a-bissell/microfluidic-causal-chamber/simulation/openfoam/README.md

# OpenFOAM T-Junction Microfluidic Simulation

This directory contains OpenFOAM simulation cases for the microfluidic T-junction causal chamber, providing an open-source alternative to the COMSOL simulation guide.

## Overview

The simulation models two-phase flow (oil-water) droplet generation at a T-junction using:
- **Solver**: `interFoam` (Volume of Fluid method)
- **Physics**: Incompressible Navier-Stokes + VOF interface tracking
- **Surface tension**: Continuum Surface Force (CSF) model

## Directory Structure

```
openfoam/
├── tjunction_2d/           # 2D simulation case (start here)
│   ├── 0/                  # Initial conditions
│   │   ├── U               # Velocity field
│   │   ├── p_rgh           # Pressure
│   │   └── alpha.water     # Phase fraction
│   ├── constant/           # Physical properties
│   │   ├── transportProperties
│   │   ├── turbulenceProperties
│   │   └── g
│   ├── system/             # Solver settings
│   │   ├── blockMeshDict   # Geometry
│   │   ├── controlDict     # Run control
│   │   ├── fvSchemes       # Discretization
│   │   ├── fvSolution      # Linear solvers
│   │   └── setFieldsDict   # Initial interface
│   ├── Allrun              # Run script
│   └── Allclean            # Clean script
│
├── tjunction_2d_serpentine/ # 2D case with inlet resistor channels —
│   │                        # use this for pressure-driven (causal-chamber
│   │                        # actuation) runs; see its README
│   └── gen_blockmesh.py     # parameterized mesh generator
│
├── tjunction_2d_mill/      # digital twin of the millable 400 µm chip
│   │                        # (Makers-Guide PMMA workflow); see its README
│   └── gen_blockmesh.py
│
├── tjunction_3d/           # 3D simulation case
│   └── (same structure with parallel support)
│
├── scripts/                # Python automation
│   ├── extract_droplets.py     # Post-processing
│   ├── run_parametric.py       # Parametric sweeps
│   ├── validate_garstecki.py   # Theory validation
│   └── requirements.txt        # Python dependencies
│
└── README.md               # This file
```

## Quick Start

### Prerequisites

1. **OpenFOAM v2306+** (ESI OpenFOAM or Foundation version)
   - **Linux/Ubuntu**: `sudo apt install openfoam`
   - **Windows**: Use WSL2 (recommended), Docker, or blueCFD-Core
     - See `WINDOWS_SETUP.md` for detailed instructions
   - See: https://www.openfoam.com/download

2. **Python 3.8+** with packages:
   ```bash
   pip install -r scripts/requirements.txt
   ```

3. **ParaView** for visualization:
   ```bash
   sudo apt install paraview    # Linux
   # Windows: Download from https://www.paraview.org/download/
   ```

### Running the 2D Simulation

**Linux / WSL:**
```bash
# Navigate to case directory
cd tjunction_2d

# Make scripts executable
chmod +x Allrun Allclean

# Run the simulation
./Allrun
```

**Windows (with WSL2 installed):**
```powershell
# Navigate to case directory
cd simulation\openfoam\tjunction_2d

# Option 1: Use the batch file
.\Allrun.bat

# Option 2: Run directly through WSL
wsl bash -c "source /opt/openfoam11/etc/bashrc && ./Allrun"
```

This will:
1. Generate the mesh with `blockMesh`
2. Check mesh quality with `checkMesh`
3. Set initial water distribution with `setFields`
4. Run the simulation with `interFoam`
5. Convert results to VTK format

**Expected runtime**: 10-30 minutes (2D), 1-4 hours (3D)

### Viewing Results

```bash
# Open in ParaView
paraview VTK/tjunction_2d.vtk.series

# Or use the OpenFOAM reader
paraFoam
```

In ParaView:
1. Select `alpha.water` to visualize droplets
2. Use "Play" to animate the time series
3. Add velocity vectors with Glyph filter

## Geometry Parameters

From `system/blockMeshDict`:

| Parameter | Value | Description |
|---|---|---|
| w_main | 150 μm | Main channel width |
| w_disp | 75 μm | Dispersed channel width |
| depth | 80 μm | Channel depth |
| L_oil | 500 μm | Oil inlet length |
| L_water | 300 μm | Water inlet length |
| L_outlet | 1000 μm | Outlet length |

## Fluid Properties

From `constant/transportProperties`:

| Phase | Property | Value |
|---|---|---|
| Oil (continuous) | ν | 5×10⁻⁵ m²/s (50 cSt) |
| | ρ | 960 kg/m³ |
| Water (dispersed) | ν | 1×10⁻⁶ m²/s |
| | ρ | 1000 kg/m³ |
| Interface | σ | 0.03 N/m |

## Boundary Conditions

From `0/U` and `0/p_rgh` (velocity-driven, the default since the 2026-07 fix):

| Boundary | Condition | Value |
|---|---|---|
| oil_inlet | fixedValue U | 20 mm/s (Ca = 0.032) |
| water_inlet | fixedValue U | 10 mm/s (Q_disp/Q_cont = 0.25) |
| outlet | fixedValue p | 0 (gauge) |
| walls | noSlip, contact angle | theta0 = 160° (oil-wet) |

> **Why not the original 50/30 kPa pressure inlets?** Over this short
> domain (1.65 mm), 50 kPa drives ~1.2 m/s of oil — a capillary number of
> ~1.9, two orders of magnitude above the droplet-forming regime
> (Ca ≲ 0.02), and the resulting junction pressure (~33 kPa) exceeds the
> 30 kPa water inlet, so water cannot flow in at all. The result is a
> steady stratified film and zero droplets. For pressure-driven runs
> (matching the causal-chamber actuation model), use totalPressure with
> p0 ≈ 850 Pa (oil) and ≈ 650 Pa (water) instead — real chips only see
> tens of kPa because most of it drops across tubing and long serpentine
> channels that this geometry doesn't include.

## Post-Processing

### Extract Droplet Metrics

```bash
python scripts/extract_droplets.py tjunction_2d --output results.csv
```

This extracts:
- Droplet positions and dimensions
- Formation frequency
- Size distribution statistics

### Validate Against Theory

```bash
python scripts/validate_garstecki.py results.csv --plot
```

Compares results to Garstecki scaling law:
```
L/w = 1 + α × (Q_disp/Q_cont)
```

### Parametric Sweep

Preferred: the Docker-based concurrent driver (no local OpenFOAM needed;
runs unchanged on macOS or a many-core Linux/WSL2 box):

```bash
python3 scripts/sweep_pressure.py \
    --base-case tjunction_2d_serpentine \
    --output-dir ~/sweeps/psweep_5x5 \
    --p-cont 10000 11500 13000 14500 16000 \
    --p-disp 2400 2700 3000 3300 3600 \
    --repeats 3 --concurrency 12          # 12 for a 12-core CPU

python3 scripts/analyze_pressure_sweep.py --sweep-dir ~/sweeps/psweep_5x5
```

The analyzer writes per-case metrics, response-map heatmaps, and a
causal-chamber-schema `causal_dataset.csv`. On WSL2, keep `--output-dir`
inside the WSL filesystem (not `/mnt/c/...`) — OpenFOAM's many small
writes are very slow across the Windows bridge; the driver warns if it
detects this.

Legacy sequential driver (requires a local OpenFOAM install):
`scripts/run_parametric.py`.

## Modifying Parameters

### Change Inlet Flow Rates

Edit `0/U`:
```
oil_inlet
{
    type            fixedValue;
    value           uniform (0.02 0 0);   // Keep Ca = mu*U/sigma below ~0.05
}

water_inlet
{
    type            fixedValue;
    value           uniform (0 -0.01 0);  // Sets Q_disp/Q_cont ratio
}
```

For pressure-driven operation, switch both inlets in `0/p_rgh` to
`totalPressure` (see the comments in that file) with p0 of order
100–1000 Pa — **not** tens of kPa; see Boundary Conditions above.

### Change Fluid Properties

Edit `constant/transportProperties`:
```
oil
{
    nu    5e-05;    // Kinematic viscosity (m²/s)
    rho   960;      // Density (kg/m³)
}

sigma   0.03;       // Surface tension (N/m)
```

### Change Simulation Time

Edit `system/controlDict`:
```
endTime         0.1;    // Total simulation time (s)
writeInterval   0.001;  // Output frequency (s)
```

## Troubleshooting

### Simulation Crashes

1. **Reduce time step**: Edit `system/controlDict`:
   ```
   deltaT          1e-8;    // Smaller initial time step
   maxCo           0.3;     // Lower Courant number limit
   ```

2. **Refine mesh near junction**: Add grading in `blockMeshDict`

3. **Check mesh quality**:
   ```bash
   checkMesh -allGeometry -allTopology
   ```

### No Droplets Form

1. **Check the capillary number first**: Ca = mu_cont * U_cont / sigma must
   be ≲ 0.02 (squeezing/dripping regime). Higher Ca means stratified or
   jetting flow — *lowering* velocity/pressure helps, raising it doesn't.
2. **Check the water inlet can actually flow**: with pressure inlets, the
   water p0 must exceed the pressure at the junction (roughly the oil p0
   scaled by the fraction of channel length downstream of the junction),
   or the water phase stalls entirely.
3. **Check contact angle**: walls must be oil-wet, but only moderately —
   theta0 ≥ 120 in alpha.water, comfortably ≥ 130. A measured sweep from
   60° to 170° at 800 µm puts the cliff between **105° and 120°**: 105° and
   below give a continuous thread, 120° through 170° all form plugs and are
   indistinguishable in slug length. 120° is confirmed to drip in 3D too.
   Neutral wetting (90°) does fail, so this is a real requirement.
   (An earlier revision of this list demanded theta0 ≥ 150 and said ≤ 120
   spreads a stable wall film. That was wrong by ~45°: 160° had been chosen
   *because* it dripped, and nothing between 120 and 160 had been run. See
   `results/wetting_2026-08/`.)
4. **Check interfacial tension**: `sigma` in transportProperties is an
   assumption, not a measurement, and it sets the drive — ΔP ∝ Ca·σ·L/w².
   At the designed 800 µm operating point, σ ≤ 5 mN/m gives no droplets at
   all and 8–12 mN/m gives barely-plugs at L/w ≈ 1.08. If a case will not
   drip, check sigma before reaching for the pressures.
5. **Run longer**: at Ca ~ 0.03 the droplet period is ~0.04 s; `endTime`
   must cover several periods.

### Simulation Too Slow

1. **Use 2D first**: Start with tjunction_2d
2. **Coarser mesh**: Reduce cell count in blockMeshDict
3. **Parallel run** (3D):
   ```bash
   # Decompose
   decomposePar
   # Run on 4 cores
   mpirun -np 4 interFoam -parallel
   # Reconstruct
   reconstructPar
   ```

## Output Data Format

The `extract_droplets.py` script outputs CSV compatible with the causal chamber format:

| Column | Description | Units |
|---|---|---|
| time | Simulation time | s |
| droplet_id | Droplet identifier | - |
| centroid_x | X position | μm |
| centroid_y | Y position | μm |
| length | Droplet length | μm |
| width | Droplet width | μm |
| d_equivalent | Equivalent diameter | μm |

## References

### Theory
- Garstecki et al. (2006), "Formation of droplets and bubbles in a microfluidic T-junction", Lab Chip
- Christopher & Anna (2007), "Microfluidic methods for generating continuous droplet streams"

### OpenFOAM
- OpenFOAM User Guide: https://www.openfoam.com/documentation/user-guide
- interFoam documentation: https://www.openfoam.com/documentation/guides/latest/doc/guide-applications-solvers-multiphase-interFoam.html

### Causal Chambers
- Gamella et al. (2025), "Causal chambers as a real-world physical testbed for AI methodology", Nature Machine Intelligence
- Microfluidic chamber plan: `hardware/microfluidic/microfluidic_chamber_plan.md`

## Results

- `droplet_verification.png` — filmstrip of the first verified droplet
  formation after the July 2026 BC fix (2D, corrected boundary conditions).
- [`results/mill3d800_2026-08/`](results/mill3d800_2026-08/) — **the 2D→3D
  correction, measured properly**: 800 µm in 3D against a 2D baseline from
  the same generator, so dimensionality is the only variable. Corner gutters
  make slugs ×0.87 shorter, ×1.12 wider, ×0.63 in volume, at ×1.59 the rate
  and ×1.17 the speed. Validated three ways — mass conservation exact, 3D
  reproduces the textbook square-channel slug bypass ratio (1.31 vs ~1.33)
  which 2D cannot, and the 2D baseline reproduces the pressure-driven run
  exactly. Replaces the withdrawn `mill3d_2026-07` factors.
- [`results/window600_2026-07/`](results/window600_2026-07/) — **operating
  window at 600 µm: 25/25 cells drip at ±30% on both actuators** (12.3–22.9
  cm oil × 5.9–11.0 cm water), so the window's edges are still outside the
  sweep. L/w monotonic in every cell (1.15–2.21); the centre cell reproduces
  the independently-run scale-up case to 7 significant figures. The worry
  that a larger capillary-threshold fraction would narrow the window at
  greater width is not borne out.
- [`results/scaleup_2026-07/`](results/scaleup_2026-07/) — **the chamber
  scales**: 400 → 600 → 800 µm reproduce each other to within 4% on every
  observable (L/w 1.500/1.554/1.550, speed flat at ~28 mm/s, f ∝ 1/w,
  Q ∝ w²), with the 600 and 800 µm points predicted out-of-sample from the
  verified 400 µm one. Drops the fabrication bar from a 1/64" endmill to a
  0.6–0.8 mm tool (stiffness ∝ d⁴). Bo = 0.008 at 800 µm, so there is ~10×
  more width headroom before gravity matters; the binding constraint is
  actuation tolerance, not physics.
- [`results/cyclicity_2026-07/`](results/cyclicity_2026-07/) — **actuation
  mode determines the causal graph**: pressure-driven inlets oscillate at
  exactly the droplet frequency (an emergent, physics-delivered confounded
  pair); velocity-driven inlets are flat to six significant figures
  (severed edges — a syringe pump as physical do-operator). The *strength*
  of the coupling is case-specific, not a chamber constant: a same-geometry
  A/B gives r = +0.31, not the +0.998 first reported, because the coupling
  is impulsive rather than sinusoidal. See the correction in that README.
- [`results/mill3d_2026-07/`](results/mill3d_2026-07/) — the first 3D run:
  the millable chip's junction in full 3D. **Partly superseded** — the run
  was fed 79% more water than the 2D case it was compared against (q = 0.5
  vs the 2D measured 0.28), so the ×1.43 speed and ×2.4 frequency
  "corrections" are confounded and withdrawn. The +3% slug-length
  agreement stands. The BC is fixed; a corrected 3D run has not been made.
- [`results/mesh_convergence_2026-07/`](results/mesh_convergence_2026-07/) —
  9-point 5 µm vs 7.5 µm check on the serpentine case. Solver-level result
  is solid at every point (droplets form, same regime as 7.5 µm). After a
  follow-up run at 2× endTime, 4 of 9 points have clean, repeatable L/w
  measurements agreeing with the published 7.5 µm data to within 3–19%;
  the other 5 (high total flow) surfaced a genuinely open question — either
  a domain-length-limited clustering artifact or a real regime transition
  at the sweep's highest-flow corner — flagged with a concrete next step.
- [`results/mill_2026-07/`](results/mill_2026-07/) — first solve of the
  millable-chip twin (`tjunction_2d_mill`): reference-point verification
  (droplets within 11–23% of the hydraulic design math) plus a 25-case
  operating-window sweep, L/w and speed perfectly monotonic across the
  whole pressure window. Also fixed a geometry-hardcoding bug in the
  analysis scripts along the way (now parameterized, regression-checked).
- [`results/psweep5x5_2026-07/`](results/psweep5x5_2026-07/) — the first full
  dataset: 75 cases (5×5 grid × 3 noisy repeats), droplets in all of them,
  L/w and speed monotonic across every row and column, median repeat
  CV 2.2%. Includes the causal-chamber-schema `causal_dataset.csv`.
- [`results/protocol_v1_2026-07/`](results/protocol_v1_2026-07/) — first
  time-series (SET/WAIT/MSR-style) dataset: 6 chained runs, each a
  shuffled tour of the same 3×3 grid as `psweep_2026-07`. Cross-checked
  against that independent cold-start pilot: median |ΔL/w| = 0.7%. The
  raw material for changepoint detection / temporal causal discovery.
- [`results/psweep_2026-07/`](results/psweep_2026-07/) — pressure-actuated 3×3
  sweep on the serpentine case: droplets in all 9 cells, monotonic
  L/w and speed response maps (the P → Q → droplet causal mechanism).
- [`results/sweep_2026-07/`](results/sweep_2026-07/) — first parametric
  sweep: 9 velocity-driven cases (all forming droplets, 10–43 Hz) recovering
  the Garstecki scaling law with α = 1.24, R² = 0.94, plus pressure-driven
  pilots mapping the capillary entry-pressure threshold.

## Viewer

A dependency-free static viewer for the results lives in [`viewer/`](viewer/):
a 2D `alpha.water` playback of a drip cycle, the 3D droplet isosurface, and
swept droplet metrics. No backend, no build step — serve the folder and open it:

```bash
python3 -m http.server 8000   # from this directory
# open http://localhost:8000/viewer/
```

Regenerate its data from a run with [`viewer/export_web.py`](viewer/export_web.py);
see [`viewer/README.md`](viewer/README.md).

## Comparison: OpenFOAM vs COMSOL

| Aspect | OpenFOAM | COMSOL |
|---|---|---|
| Cost | Free (open-source) | ~$5,000+ license |
| Interface method | VOF | Phase Field |
| Ease of use | Command-line, steeper learning | GUI, more intuitive |
| Customization | Full source access | Limited |
| Parallelization | Excellent (MPI) | Good |
| Community | Large, active | Commercial support |

Both approaches are valid for this application. OpenFOAM provides a free, fully open-source solution that can be shared without license restrictions.

## License

This simulation setup is provided under the MIT License as part of the Microfluidic Causal Chamber project.

## Contact

For questions about this simulation:
- Open an issue on GitHub
- See the main project README for contact information
