a-bissell/microfluidic-causal-chamber/hardware/microfluidic/mcc_plumbing.png

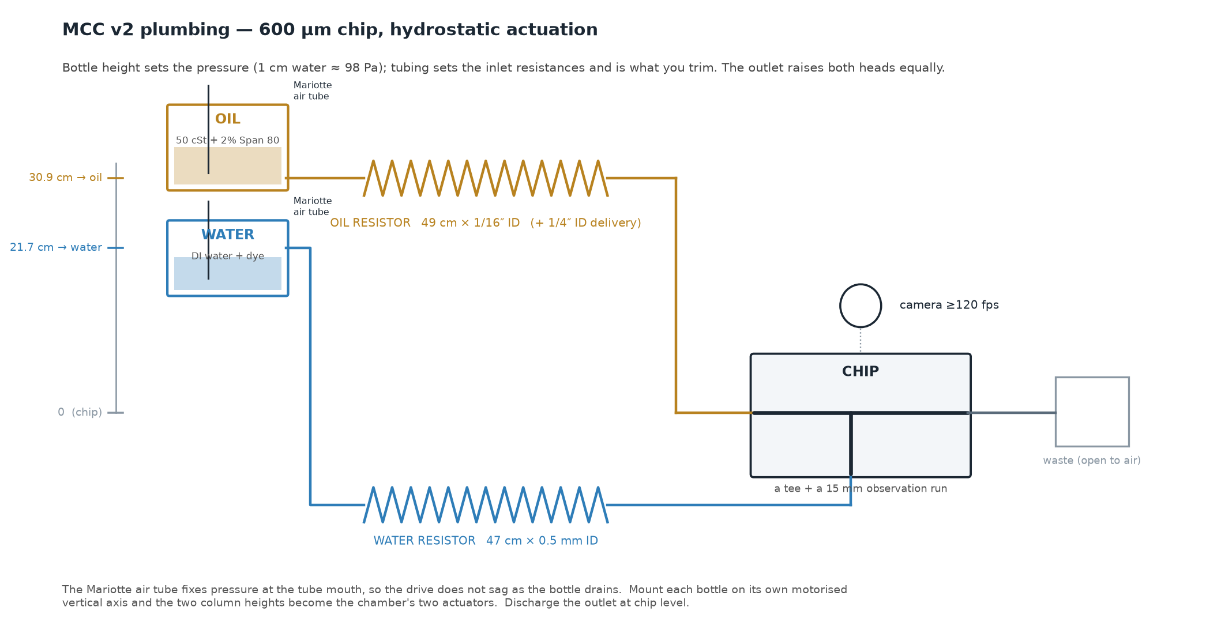
hardware/microfluidic/mcc_plumbing.png
