a-bissell/microfluidic-causal-chamber/hardware/microfluidic/mill_chip_v1_preview.png

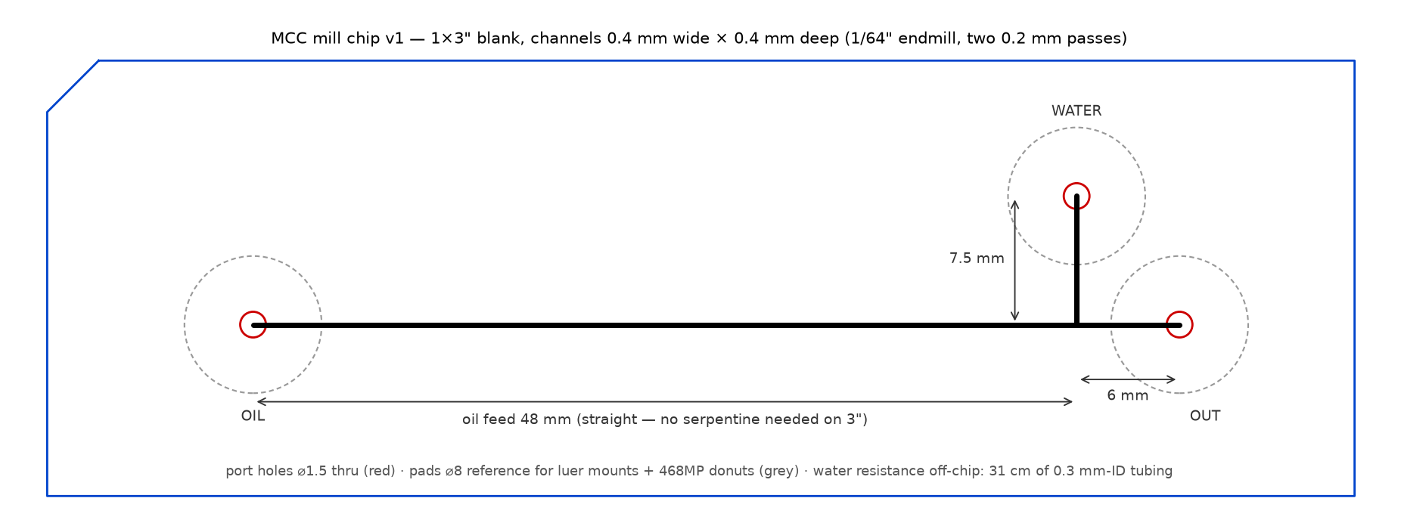
hardware/microfluidic/mill_chip_v1_preview.png
