a-bissell/microfluidic-causal-chamber/hardware/microfluidic/mill_chip_v2_layout.png

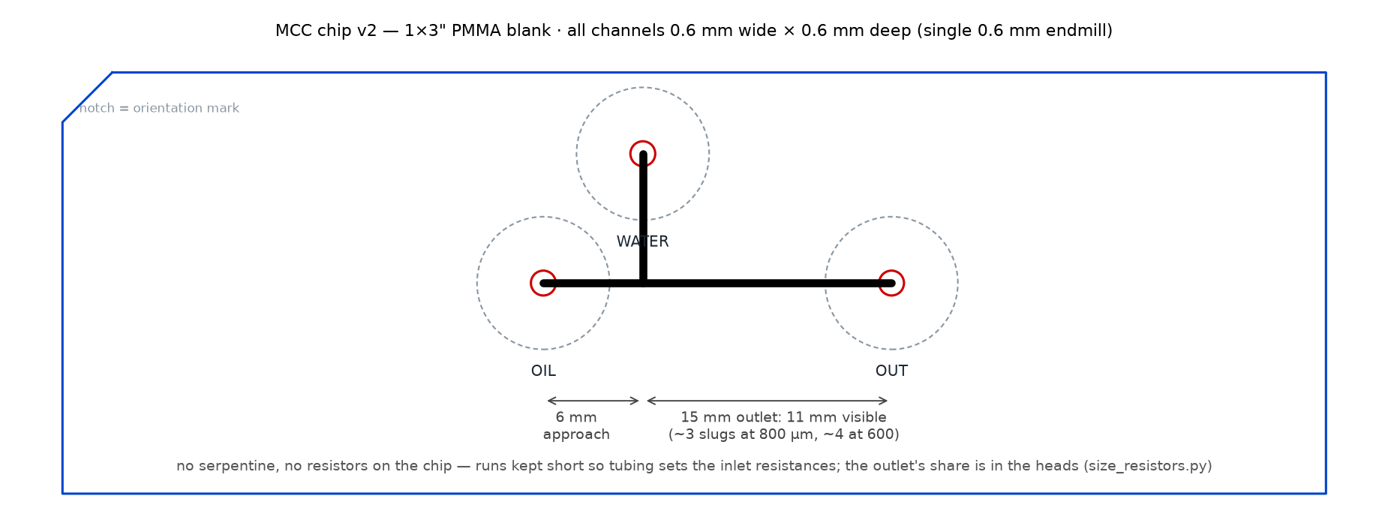
hardware/microfluidic/mill_chip_v2_layout.png
