a-bissell/microfluidic-causal-chamber/hardware/microfluidic/print_test/print_test_plate.step

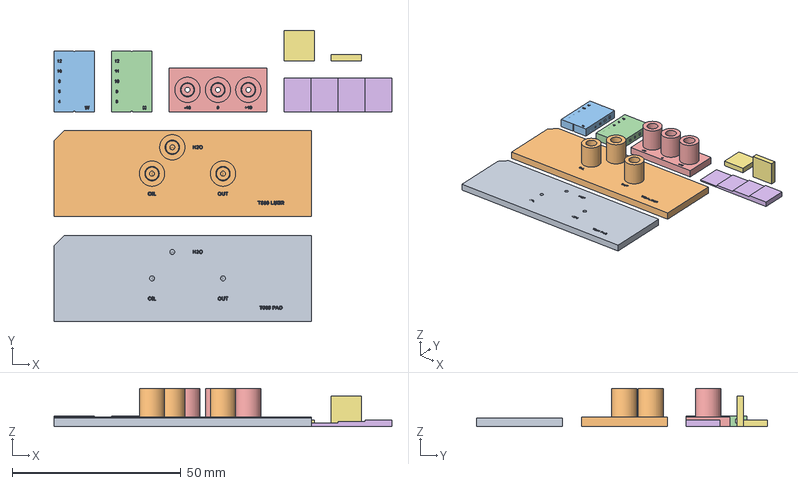
[picture p7: CAD file, 2026-10-15]
hardware/microfluidic/print_test/print_test_plate.step
100.0 x 86.0 x 11.3 mm
T600_pad
T800_luer
W_width
H_height
LUER_gauge
OPT_wedge
THF_flat
THV_upright
