a-bissell/microfluidic-causal-chamber/hardware/microfluidic/print_test/stl/T600_pad.stl

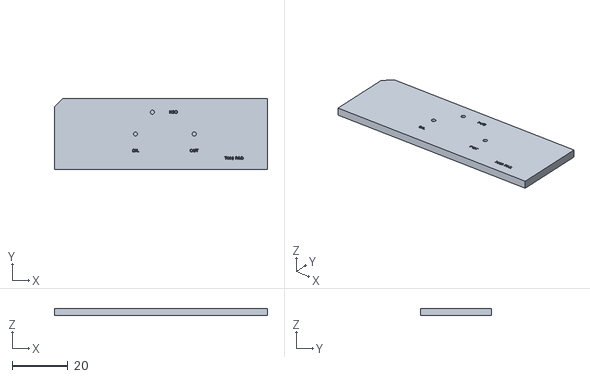
[picture p8: CAD file, 2026-10-15]
hardware/microfluidic/print_test/stl/T600_pad.stl
76.2 x 25.4 x 2.60
