a-bissell/microfluidic-causal-chamber/hardware/microfluidic/print_test/stl/T800_luer.stl

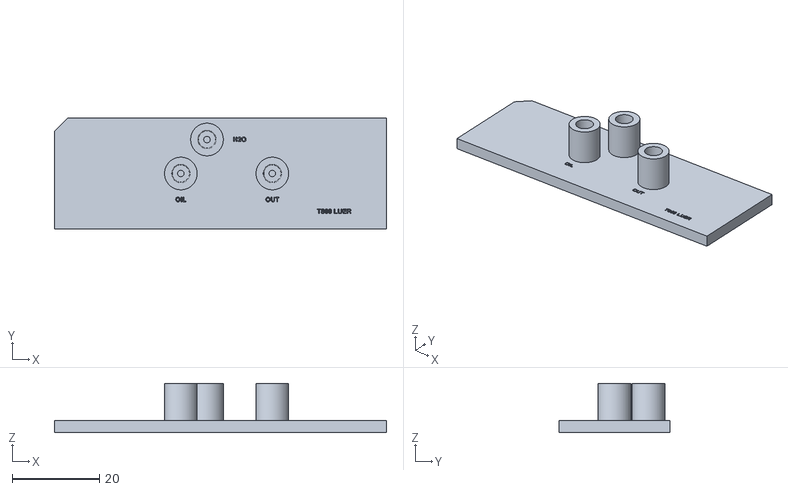
[picture p9: CAD file, 2026-10-15]
hardware/microfluidic/print_test/stl/T800_luer.stl
76.2 x 25.4 x 11.3
