a-bissell/microfluidic-causal-chamber/hardware/microfluidic/print_test/stl/W_width.stl

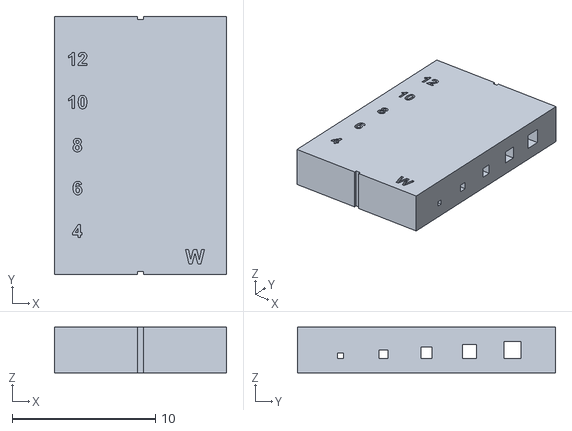
[picture p11: CAD file, 2026-10-15]
hardware/microfluidic/print_test/stl/W_width.stl
12.0 x 18.0 x 3.20
