a-bissell/microfluidic-causal-chamber/hardware/microfluidic/print_test/stl/OPT_wedge.stl

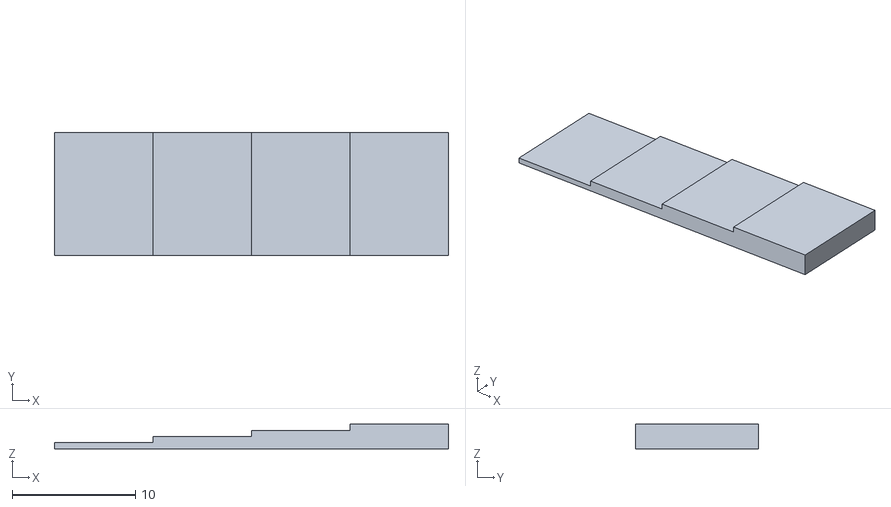
[picture p12: CAD file, 2026-10-15]
hardware/microfluidic/print_test/stl/OPT_wedge.stl
32.0 x 10.0 x 2.00
