a-bissell/microfluidic-causal-chamber/hardware/microfluidic/print_test/stl/LUER_gauge.stl

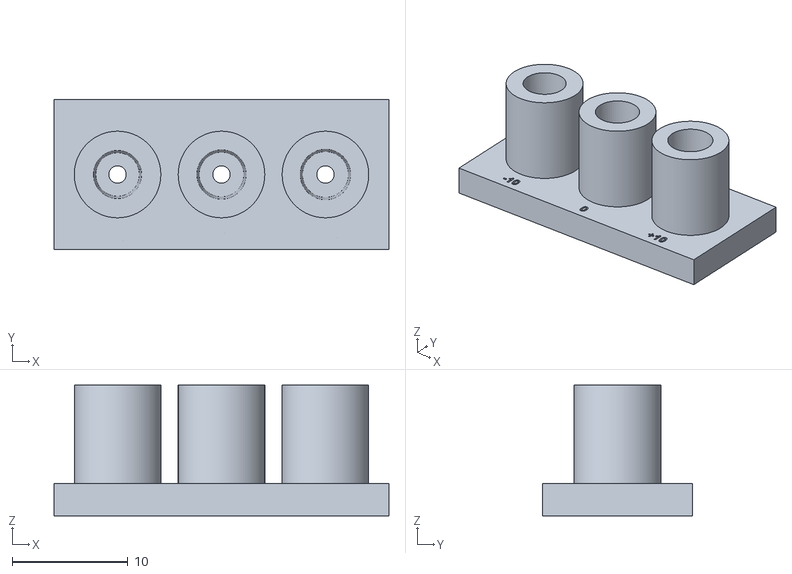
[picture p13: CAD file, 2026-10-15]
hardware/microfluidic/print_test/stl/LUER_gauge.stl
29.0 x 13.0 x 11.3
