a-bissell/microfluidic-causal-chamber/hardware/microfluidic/print_test/stl/THV_upright.stl

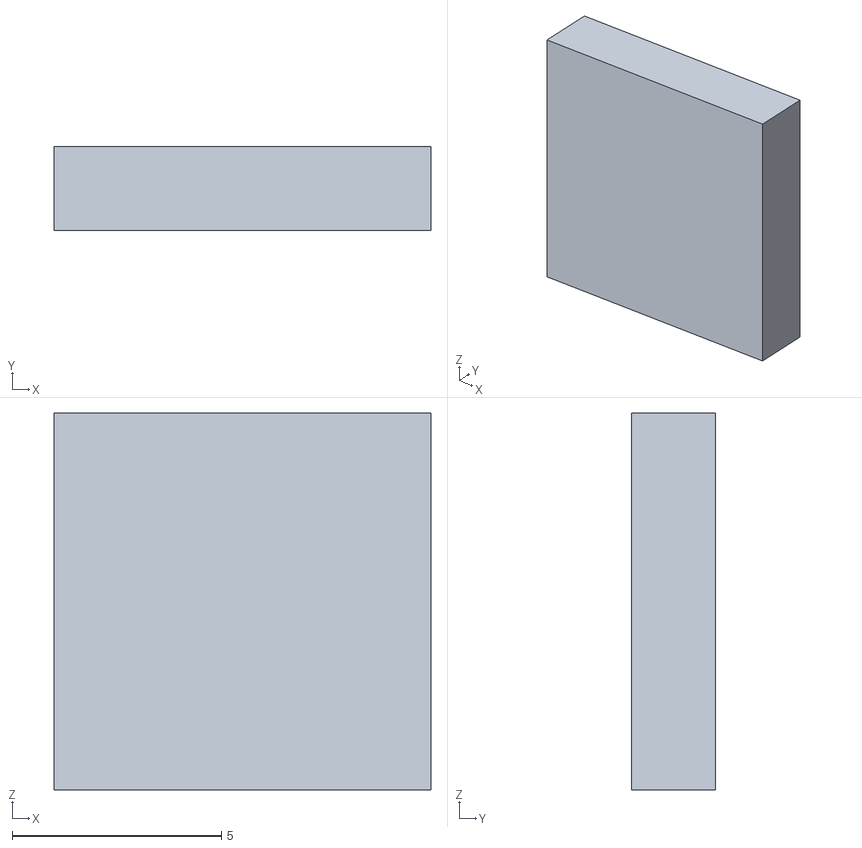
[picture p14: CAD file, 2026-10-15]
hardware/microfluidic/print_test/stl/THV_upright.stl
9.00 x 2.00 x 9.00
