a-bissell/microfluidic-causal-chamber/(list of files, cad)

Other CAD files:
hardware/microfluidic/print_test/stl/THF_flat.stl
