a-bissell/microfluidic-causal-chamber/simulation/openfoam/results/cyclicity_2026-07/ab_flux_pressure_arm.csv

time | Q_oil_inlet_uL_s | Q_water_inlet_uL_s
0.0 | 0.0 | 0.0
0.001 | 0.2374819399484238 | 0.07762473382192556
0.002 | 0.23719471113407808 | 0.07599027639530428
0.003 | 0.23669033627218908 | 0.07707785161430558
0.004 | 0.236071086871936 | 0.07874240118573021
0.005 | 0.23535867317935696 | 0.08090156901351099
0.006 | 0.23448911110044013 | 0.08269645045134077
0.007 | 0.23367810834795164 | 0.0839527991732622
0.008 | 0.23311274005486843 | 0.08571650105423732
0.009 | 0.2325918472562896 | 0.08701743031750193
0.01 | 0.23207739622947077 | 0.0880647724081915
0.011 | 0.2317517090092946 | 0.08917297604614775
0.012 | 0.2311884205457139 | 0.08993205671317894
0.013 | 0.23092966002642748 | 0.0906956300795383
0.014 | 0.23096597937061086 | 0.09146830619117818
0.015 | 0.23082771597054316 | 0.09222853238477938
0.016 | 0.23076340777592783 | 0.09269010024381433
0.017 | 0.23079233763440404 | 0.09306397329417244
0.018 | 0.23101294373146783 | 0.09301310520894364
0.019 | 0.23103258755903971 | 0.09175422850545997
0.02 | 0.2311787914155236 | 0.08915552604432943
0.021 | 0.23431562582490714 | 0.0705543449014995
0.022 | 0.23672970662907328 | 0.07364618258117313
0.023 | 0.23633079510501992 | 0.07346600745672423
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
