a-bissell/microfluidic-causal-chamber/simulation/openfoam/results/cyclicity_2026-07/ab_flux_velocity_arm.csv

time | Q_oil_inlet_uL_s | Q_water_inlet_uL_s
0.0 | 0.23801999249400288 | 0.08200799010036565
0.001 | 0.23801999249400288 | 0.08200799010036565
0.002 | 0.23801999249400288 | 0.08200799010036565
0.003 | 0.23801999249400288 | 0.08200799010036565
0.004 | 0.23801999249400288 | 0.08200799010036565
0.005 | 0.23801999249400288 | 0.08200799010036565
0.006 | 0.23801999249400288 | 0.08200799010036565
0.007 | 0.23801999249400288 | 0.08200799010036565
0.008 | 0.23801999249400288 | 0.08200799010036565
0.009 | 0.23801999249400288 | 0.08200799010036565
0.01 | 0.23801999249400288 | 0.08200799010036565
0.011 | 0.23801999249400288 | 0.08200799010036565
0.012 | 0.23801999249400288 | 0.08200799010036565
0.013 | 0.23801999249400288 | 0.08200799010036565
0.014 | 0.23801999249400288 | 0.08200799010036565
0.015 | 0.23801999249400288 | 0.08200799010036565
0.016 | 0.23801999249400288 | 0.08200799010036565
0.017 | 0.23801999249400288 | 0.08200799010036565
0.018 | 0.23801999249400288 | 0.08200799010036565
0.019 | 0.23801999249400288 | 0.08200799010036565
0.02 | 0.23801999249400288 | 0.08200799010036565
0.021 | 0.23801999249400288 | 0.08200799010036565
0.022 | 0.23801999249400288 | 0.08200799010036565
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
