a-bissell/microfluidic-causal-chamber/simulation/openfoam/results/cyclicity_2026-07/flux_pressure_driven_pc13k_pd3k.csv

time | Q_oil_inlet_uL_s | Q_water_inlet_uL_s
0.0 | 0.0 | 0.0
0.001 | 0.2351840954430259 | 0.07282208592169415
0.002 | 0.23484669256771162 | 0.0719275680621035
0.003 | 0.23435621789547817 | 0.07244669526152145
0.004 | 0.2337793962145963 | 0.07368670311867126
0.005 | 0.23306717514046638 | 0.07587872941568573
0.006 | 0.23235116023092617 | 0.07742400308995989
0.007 | 0.2317216703989011 | 0.07864566613436122
0.008 | 0.23098499875587727 | 0.08021943826957023
0.009 | 0.2302178855324196 | 0.08132161863528564
0.01 | 0.22968048300851465 | 0.08237421242274974
0.011 | 0.22927344738350905 | 0.0832186325966002
0.012 | 0.2288914404924696 | 0.0840653088067063
0.013 | 0.22868965680252595 | 0.08469419270599729
0.014 | 0.2284417454531683 | 0.08536459718513646
0.015 | 0.22836761553333132 | 0.08596666794597396
0.016 | 0.22843969766119848 | 0.08671853853106393
0.017 | 0.22832843628501642 | 0.08713941124258254
0.018 | 0.22844769772166743 | 0.08757075424603933
0.019 | 0.22838766988743764 | 0.08751129640234019
0.02 | 0.2284817979094341 | 0.0869124323725957
0.021 | 0.2286792114616053 | 0.08541092190044222
0.022 | 0.2287322789639319 | 0.08236524491112167
0.023 | 0.22906856089940056 | 0.08015270195766275
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
