a-bissell/microfluidic-causal-chamber/simulation/openfoam/results/cyclicity_2026-07/flux_velocity_driven_mill3d.csv

time | Q_oil_inlet_uL_s | Q_water_inlet_uL_s
0.0 | 1.5999998833984188 | 0.799999999906866
0.005 | 1.5999998833984188 | 0.799999999906866
0.01 | 1.5999998833984188 | 0.799999999906866
0.015 | 1.5999998833984188 | 0.799999999906866
0.02 | 1.5999998833984188 | 0.799999999906866
0.025 | 1.5999998833984188 | 0.799999999906866
0.03 | 1.5999998833984188 | 0.799999999906866
0.035 | 1.5999998833984188 | 0.799999999906866
0.04 | 1.5999998833984188 | 0.799999999906866
0.045 | 1.5999998833984188 | 0.799999999906866
0.05 | 1.5999998833984188 | 0.799999999906866
0.055 | 1.5999998833984188 | 0.799999999906866
0.06 | 1.5999998833984188 | 0.799999999906866
0.065 | 1.5999998833984188 | 0.799999999906866
0.07 | 1.5999998833984188 | 0.799999999906866
0.075 | 1.5999998833984188 | 0.799999999906866
0.08 | 1.5999998833984188 | 0.799999999906866
0.085 | 1.5999998833984188 | 0.799999999906866
0.09 | 1.5999998833984188 | 0.799999999906866
0.095 | 1.5999998833984188 | 0.799999999906866
0.1 | 1.5999998833984188 | 0.799999999906866
0.105 | 1.5999998833984188 | 0.799999999906866
0.11 | 1.5999998833984188 | 0.799999999906866
0.115 | 1.5999998833984188 | 0.799999999906866
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
