a-bissell/microfluidic-causal-chamber/simulation/openfoam/results/cyclicity_2026-07/ab_same_geometry.png

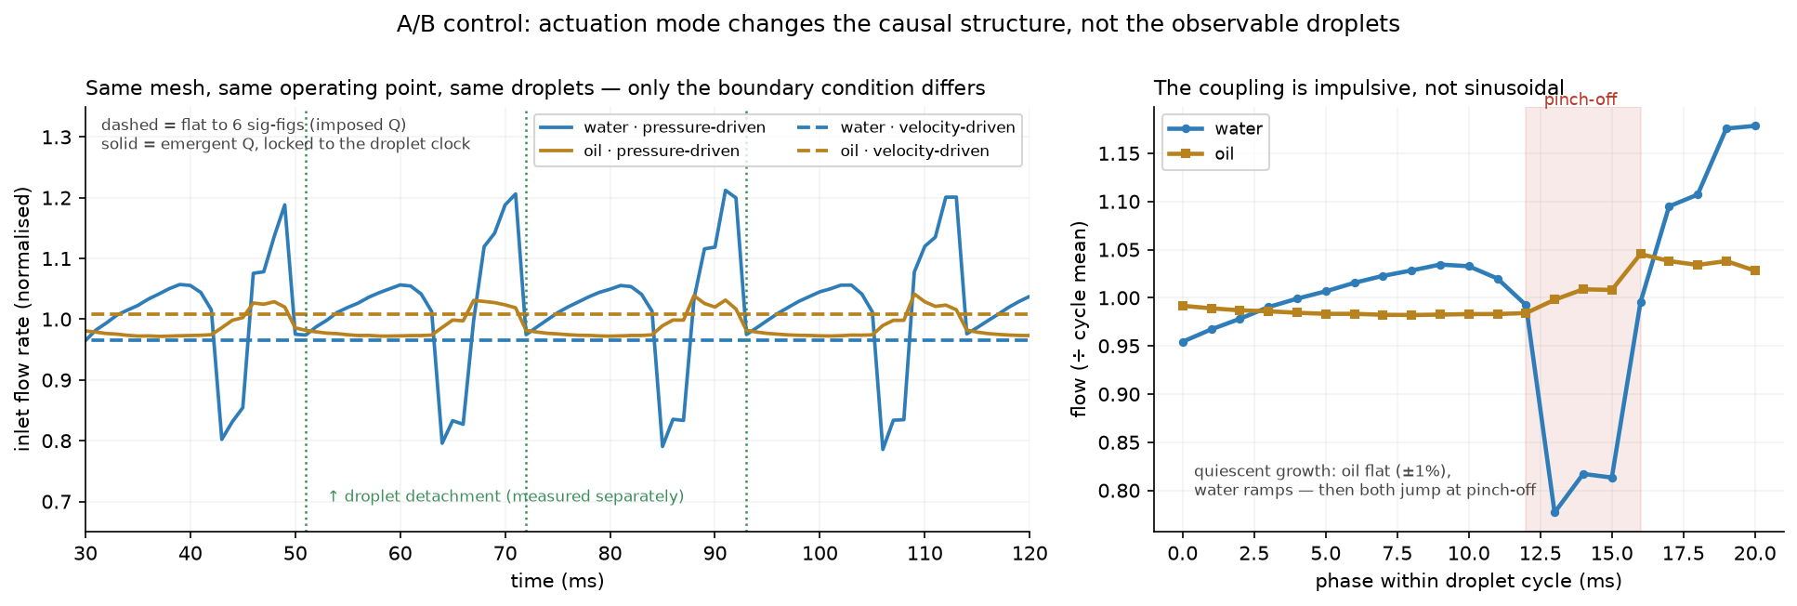
simulation/openfoam/results/cyclicity_2026-07/ab_same_geometry.png
