a-bissell/microfluidic-causal-chamber/simulation/openfoam/results/cyclicity_2026-07/actuation_mode_comparison.png

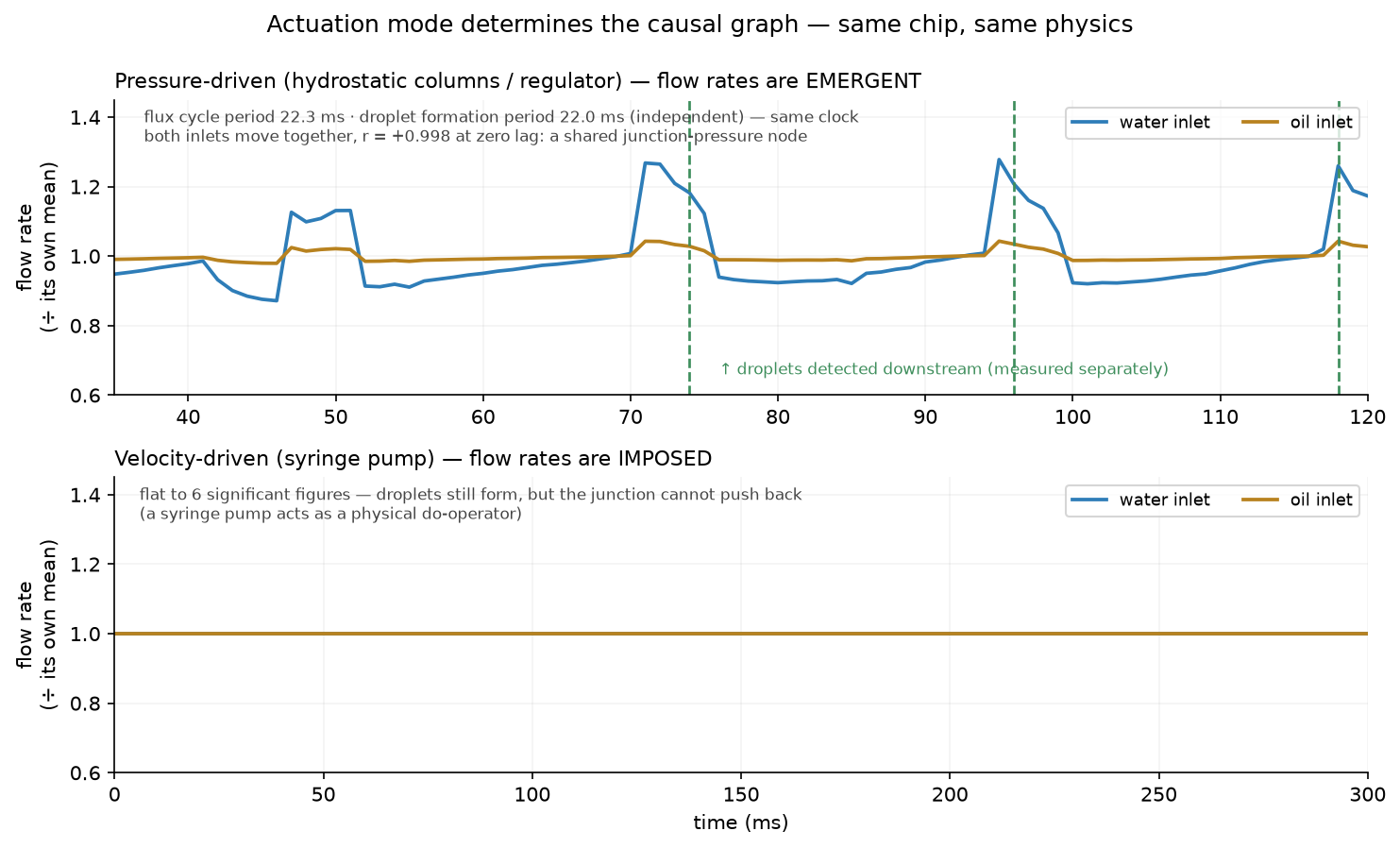
simulation/openfoam/results/cyclicity_2026-07/actuation_mode_comparison.png
