a-bissell/microfluidic-causal-chamber/simulation/openfoam/results/cyclicity_2026-07/sampling_rate_pathologies.png

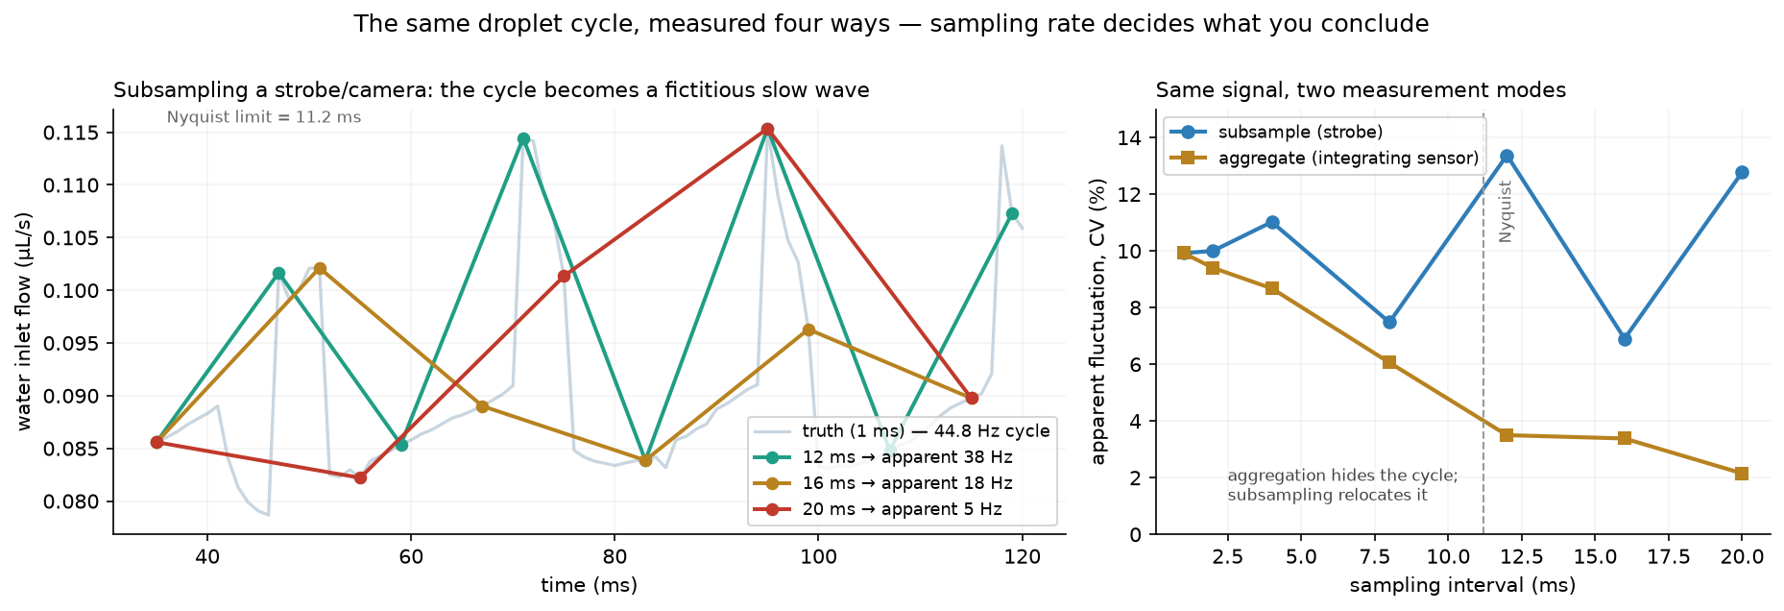
simulation/openfoam/results/cyclicity_2026-07/sampling_rate_pathologies.png
