a-bissell/microfluidic-causal-chamber/simulation/openfoam/results/mill3d800_2026-08/cmp_2d3d_800um.png

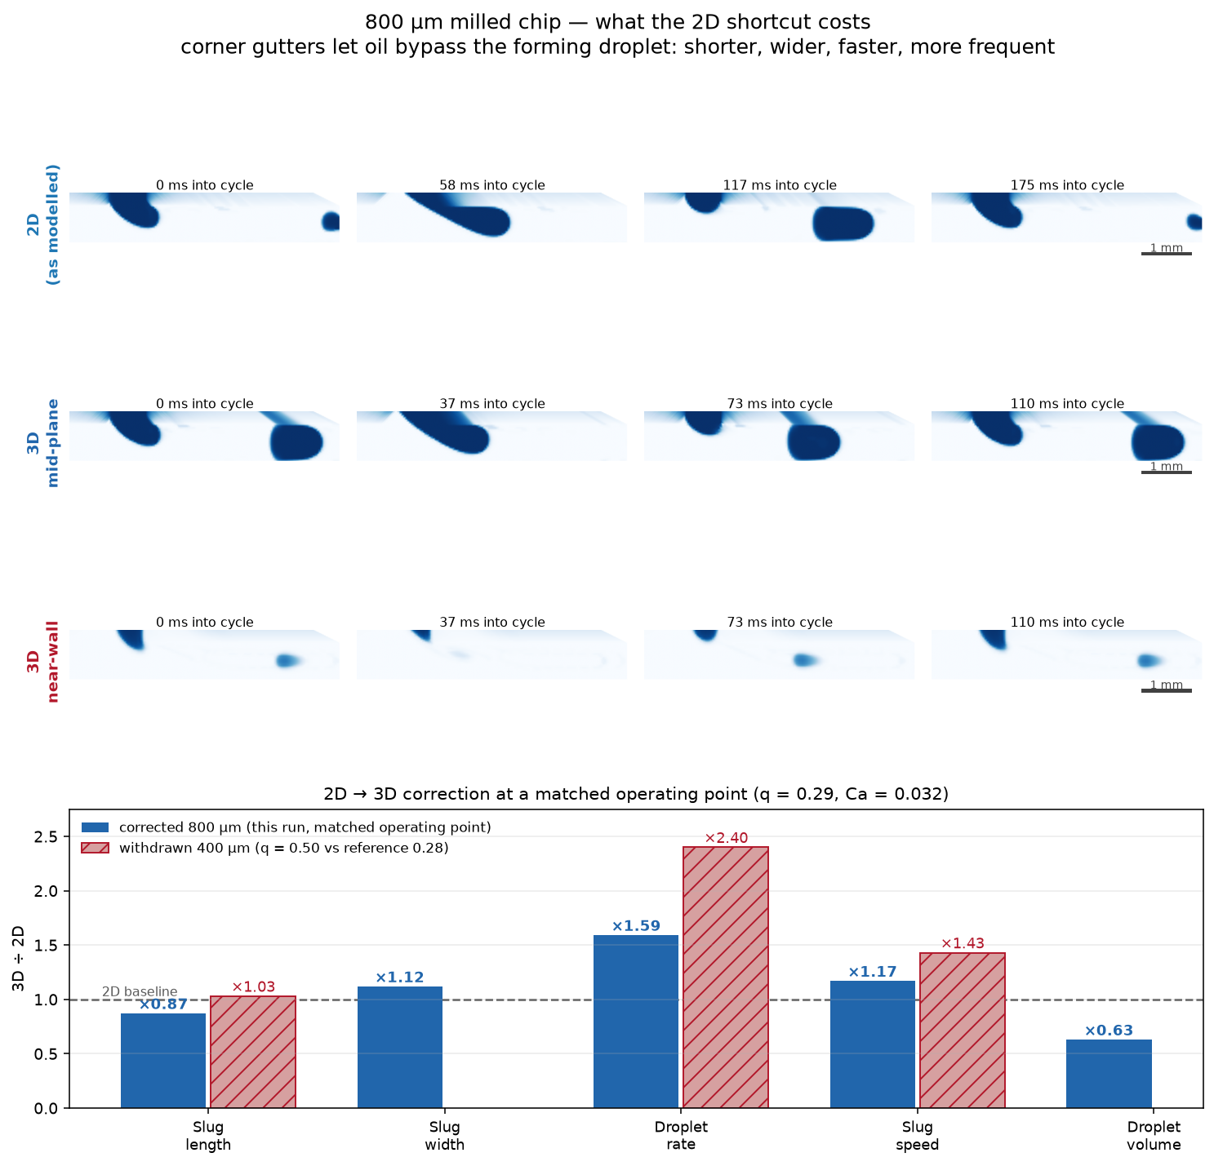
simulation/openfoam/results/mill3d800_2026-08/cmp_2d3d_800um.png
