a-bissell/microfluidic-causal-chamber/simulation/openfoam/results/mill3d800_2026-08/droplet_3d_800um.gif

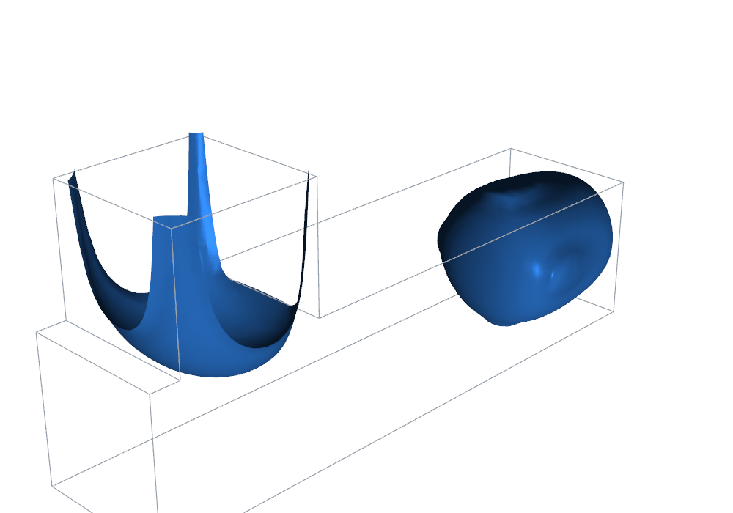
simulation/openfoam/results/mill3d800_2026-08/droplet_3d_800um.gif
