a-bissell/microfluidic-causal-chamber/simulation/openfoam/results/mill3d_2026-07/droplet_filmstrip_3d.png

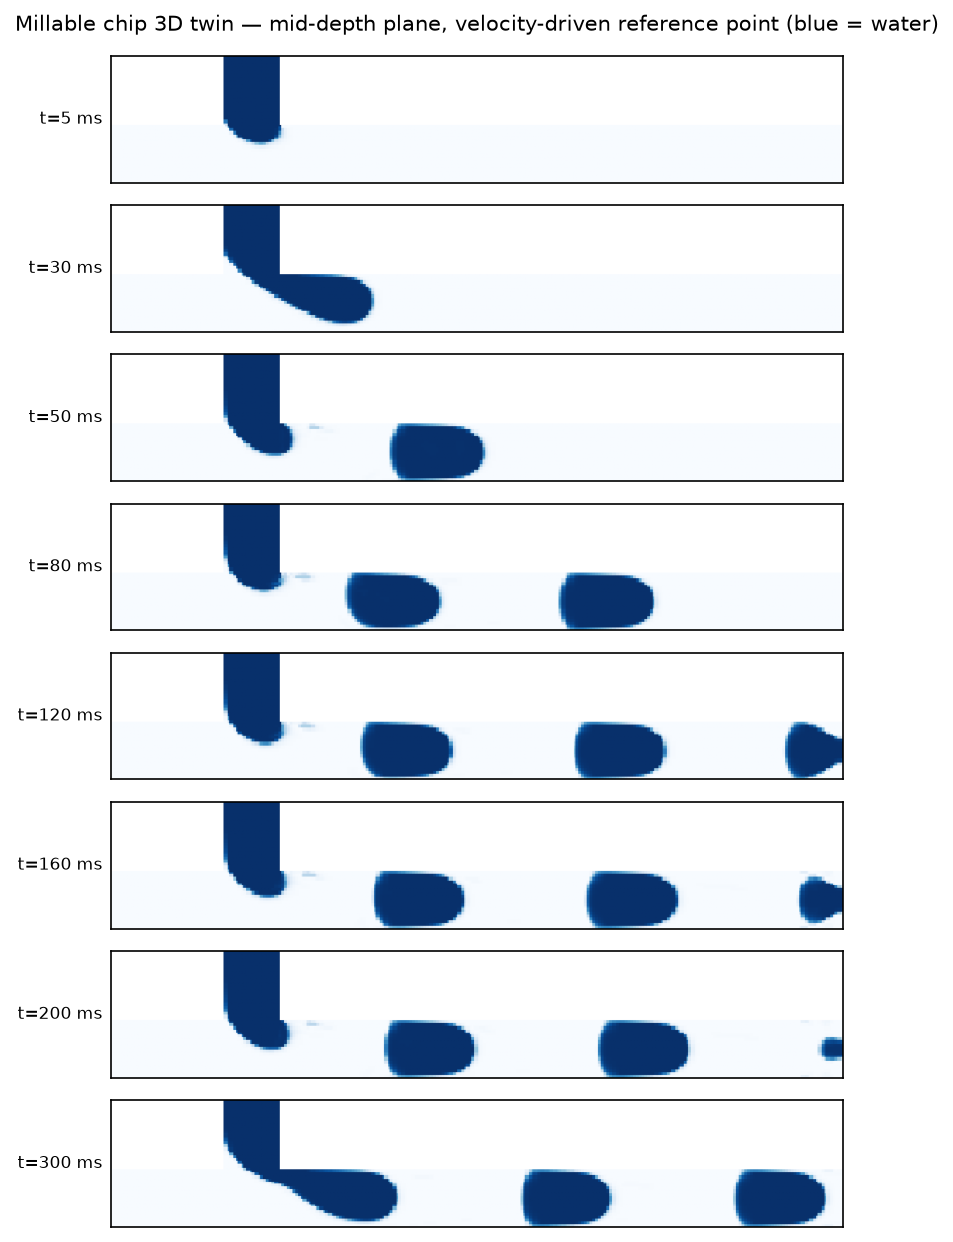
simulation/openfoam/results/mill3d_2026-07/droplet_filmstrip_3d.png
