a-bissell/microfluidic-causal-chamber/simulation/openfoam/results/mill_2026-07/droplet_filmstrip.png

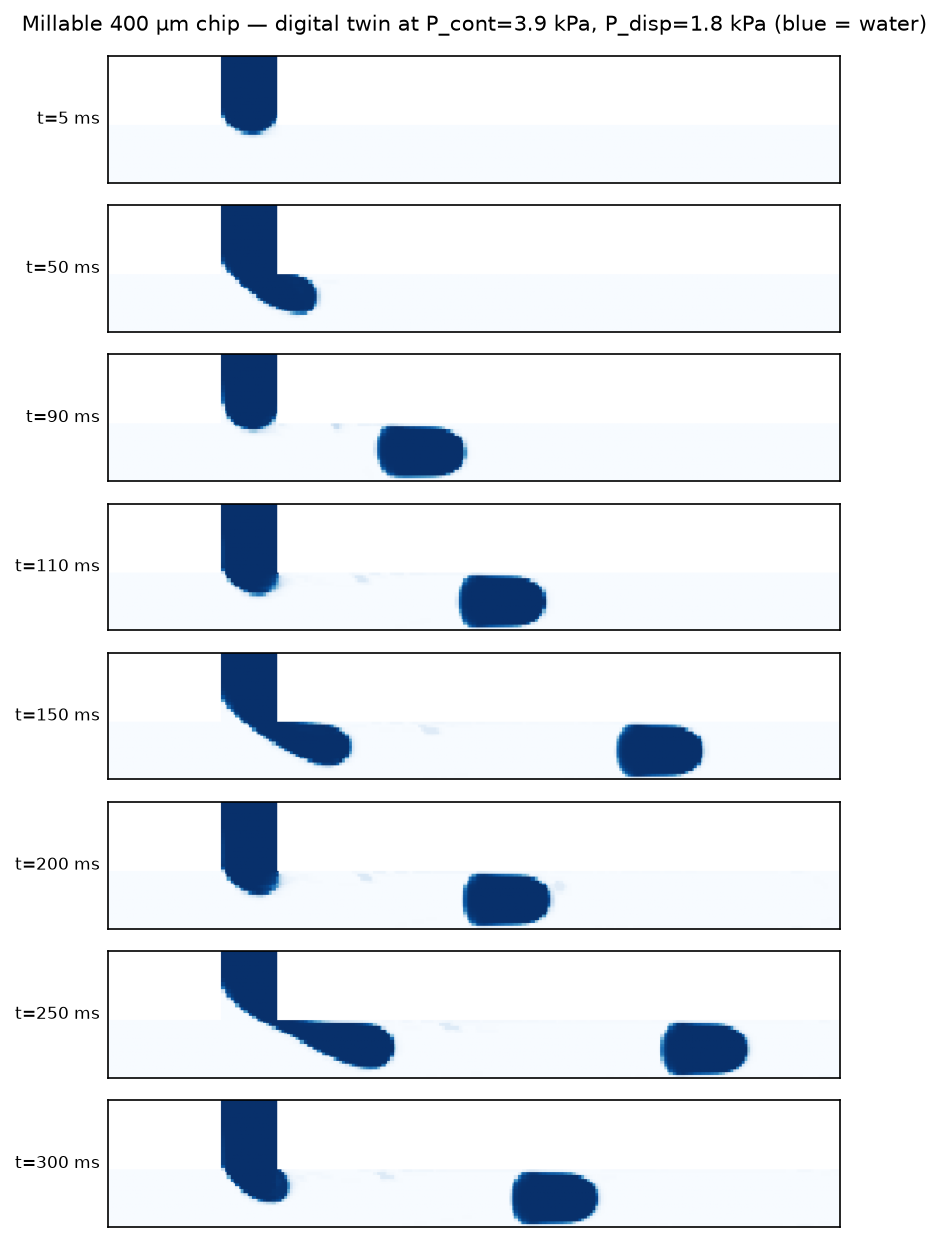
simulation/openfoam/results/mill_2026-07/droplet_filmstrip.png
