a-bissell/microfluidic-causal-chamber/simulation/openfoam/results/mill_2026-07/response_maps.png

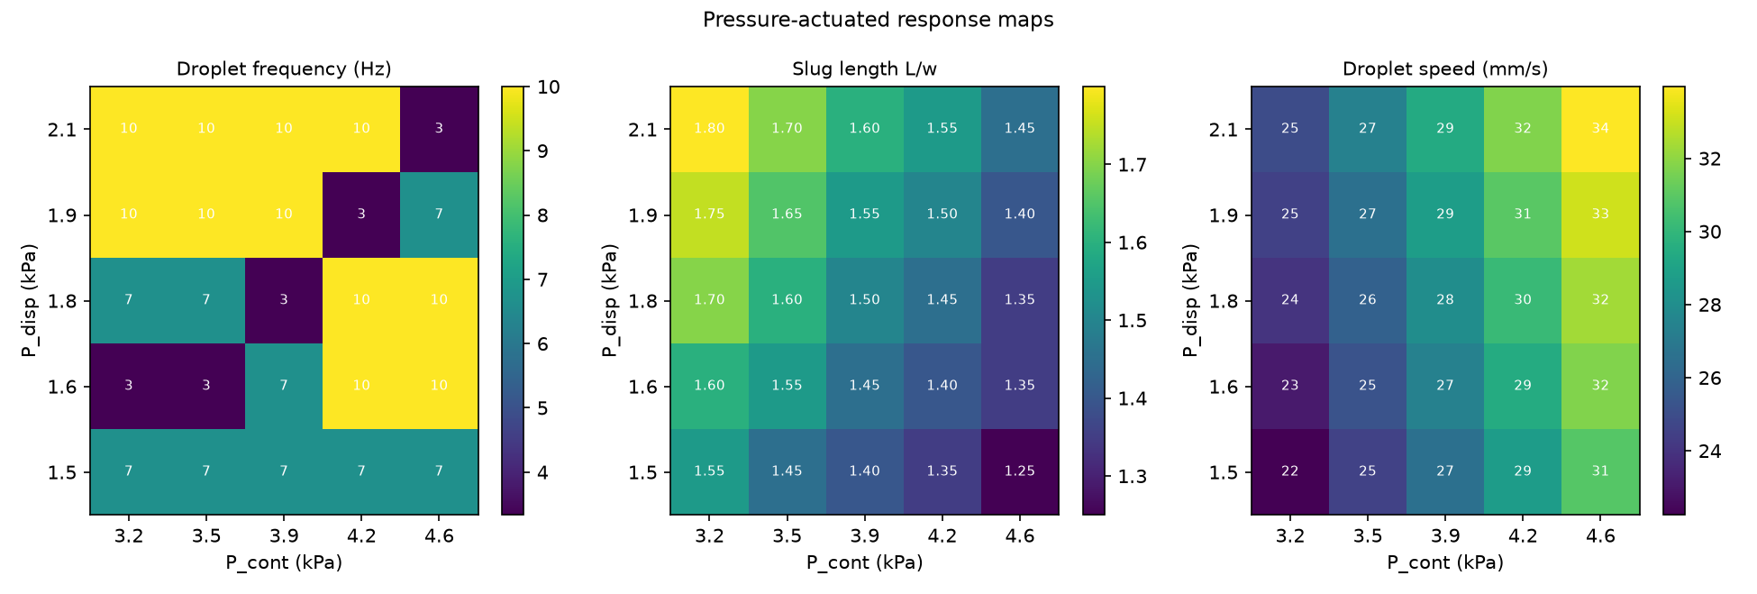
simulation/openfoam/results/mill_2026-07/response_maps.png
