a-bissell/microfluidic-causal-chamber/simulation/openfoam/results/psweep_2026-07/psweep_maps.png

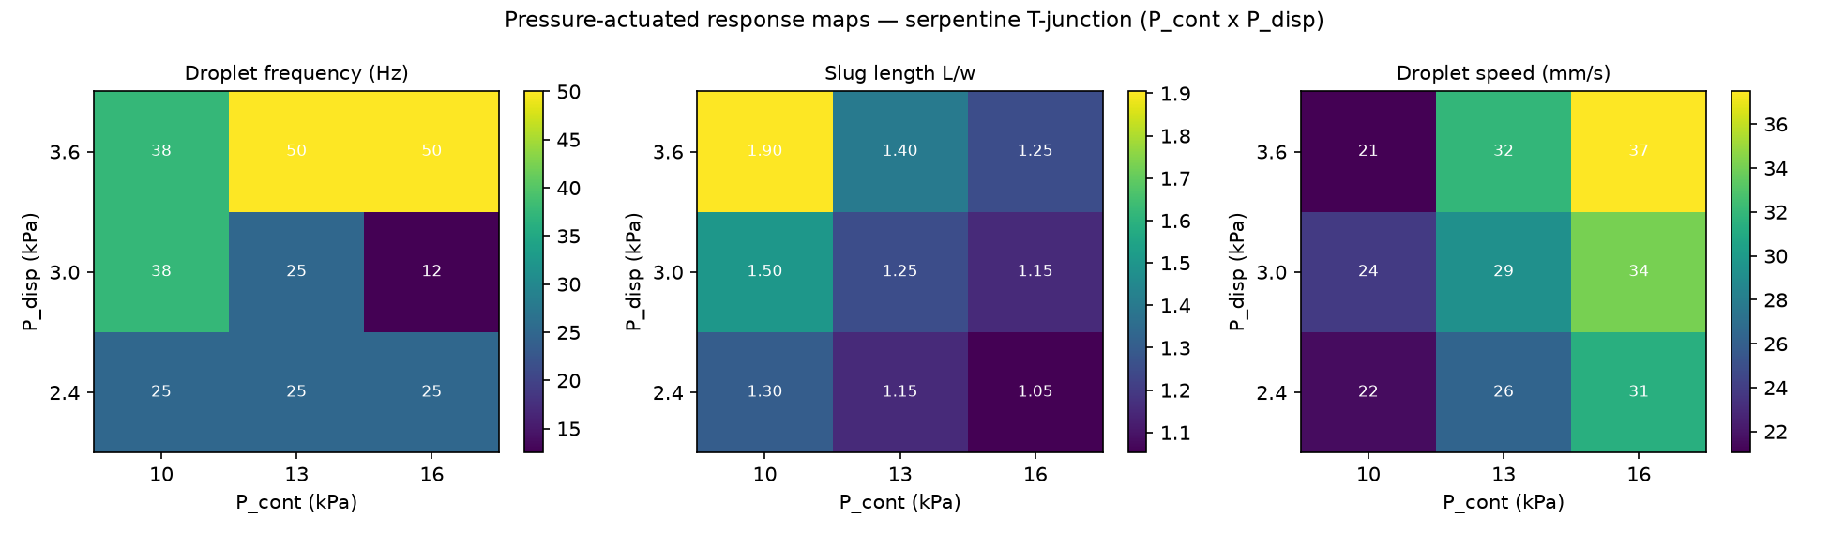
simulation/openfoam/results/psweep_2026-07/psweep_maps.png
