a-bissell/microfluidic-causal-chamber/simulation/openfoam/results/scaleup_2026-07/scale_comparison.png

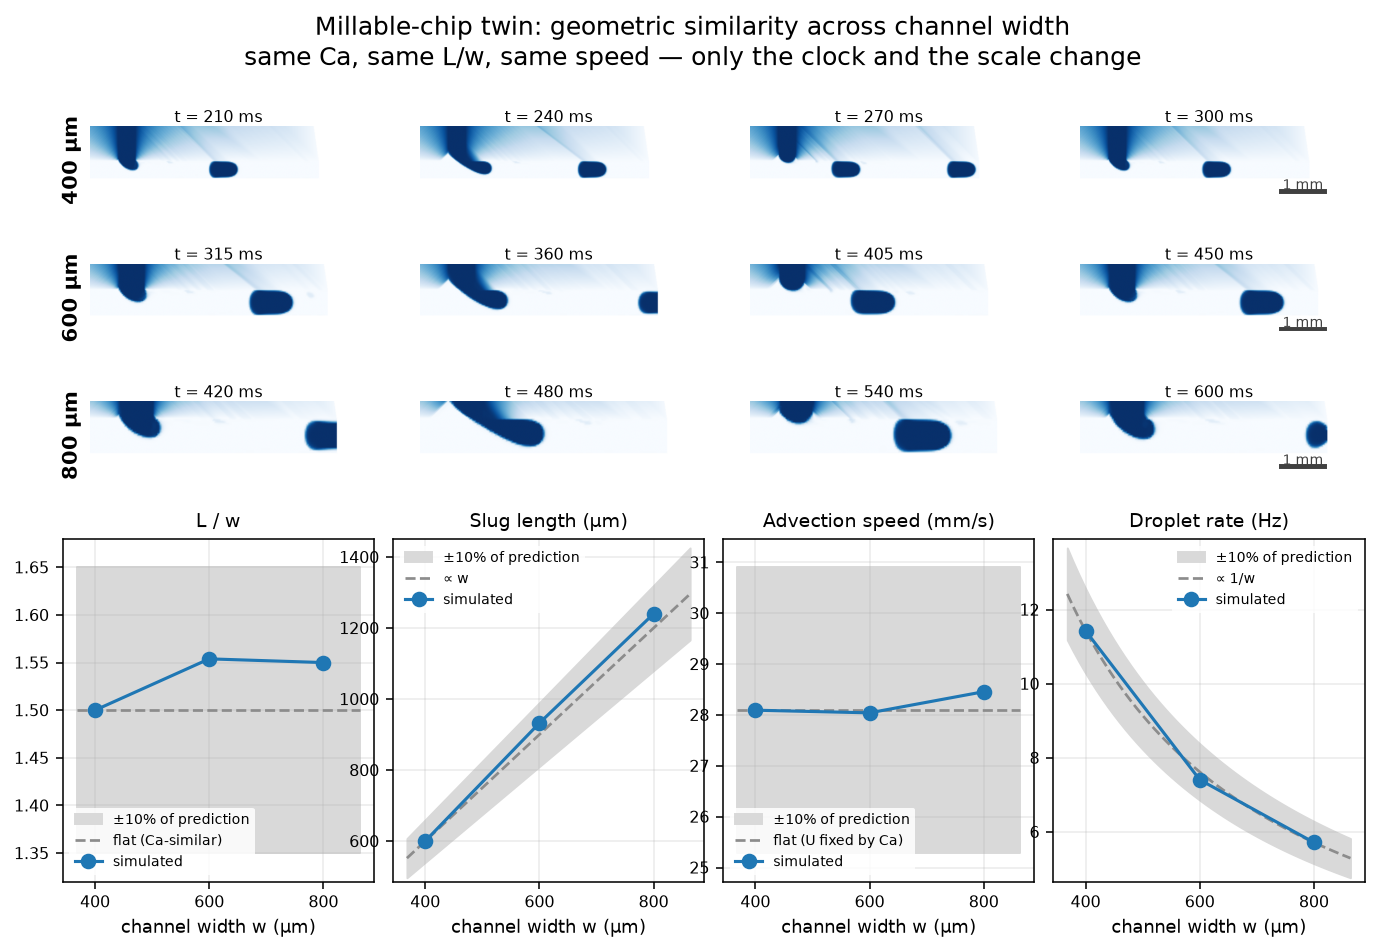
simulation/openfoam/results/scaleup_2026-07/scale_comparison.png
