a-bissell/microfluidic-causal-chamber/simulation/openfoam/results/sweep_2026-07/sweep_summary.png

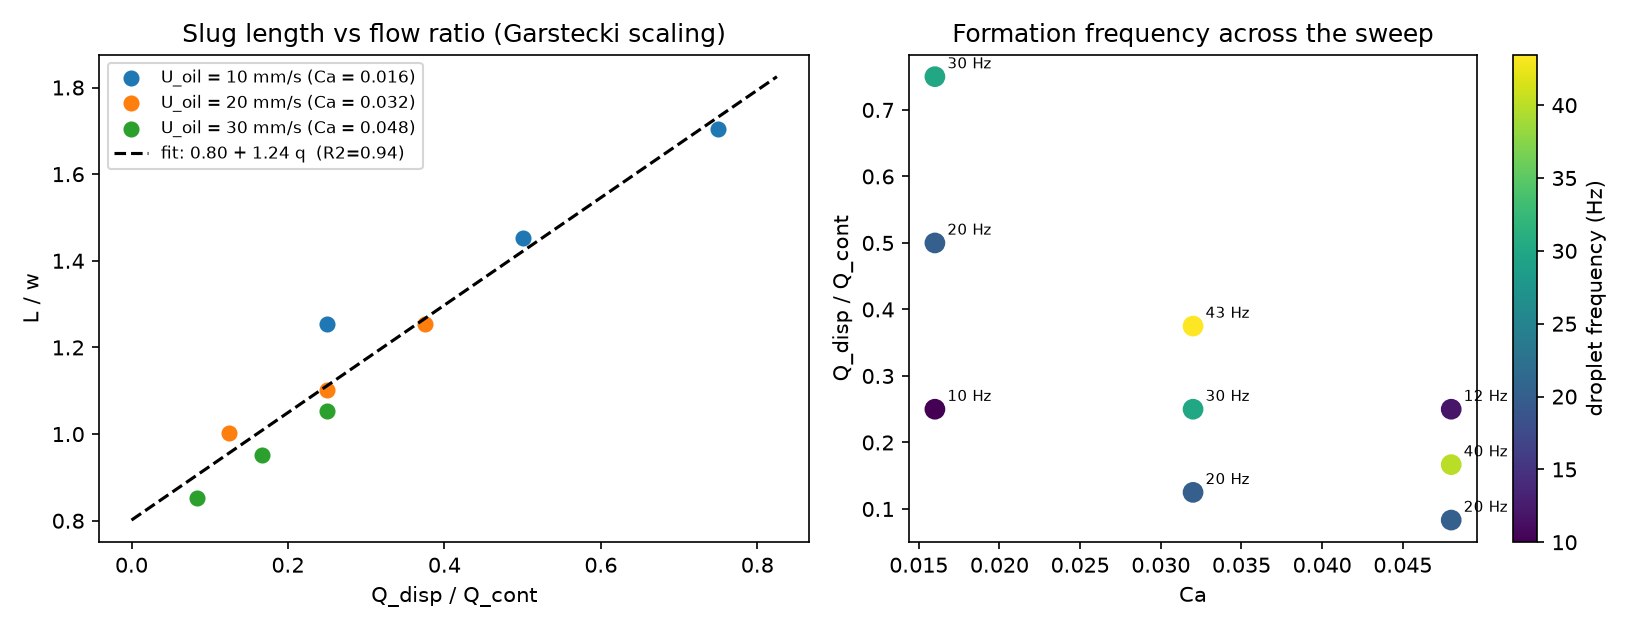
simulation/openfoam/results/sweep_2026-07/sweep_summary.png
