a-bissell/microfluidic-causal-chamber/simulation/openfoam/results/wetting_2026-08/A2_theta_low.png

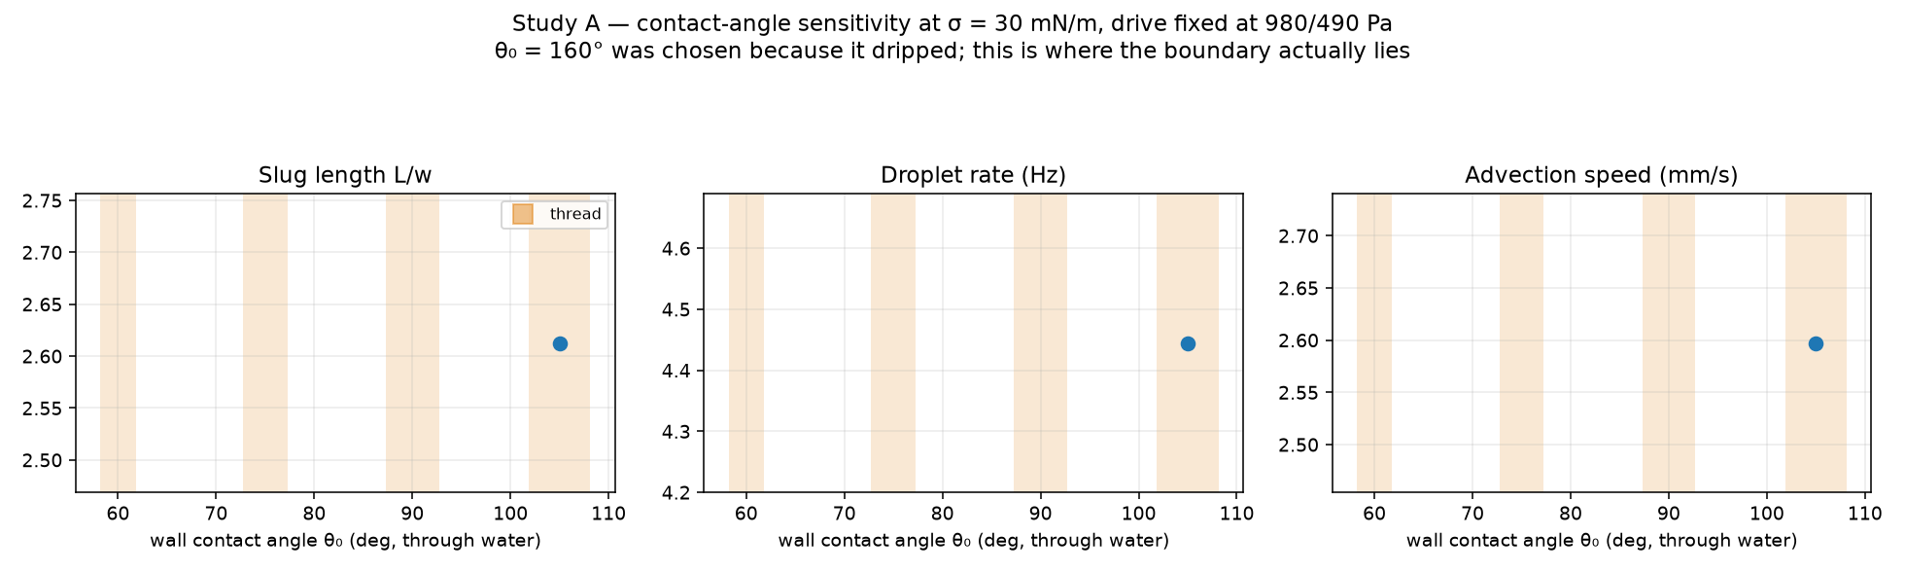
simulation/openfoam/results/wetting_2026-08/A2_theta_low.png
