a-bissell/microfluidic-causal-chamber/simulation/openfoam/results/wetting_2026-08/A_theta.png

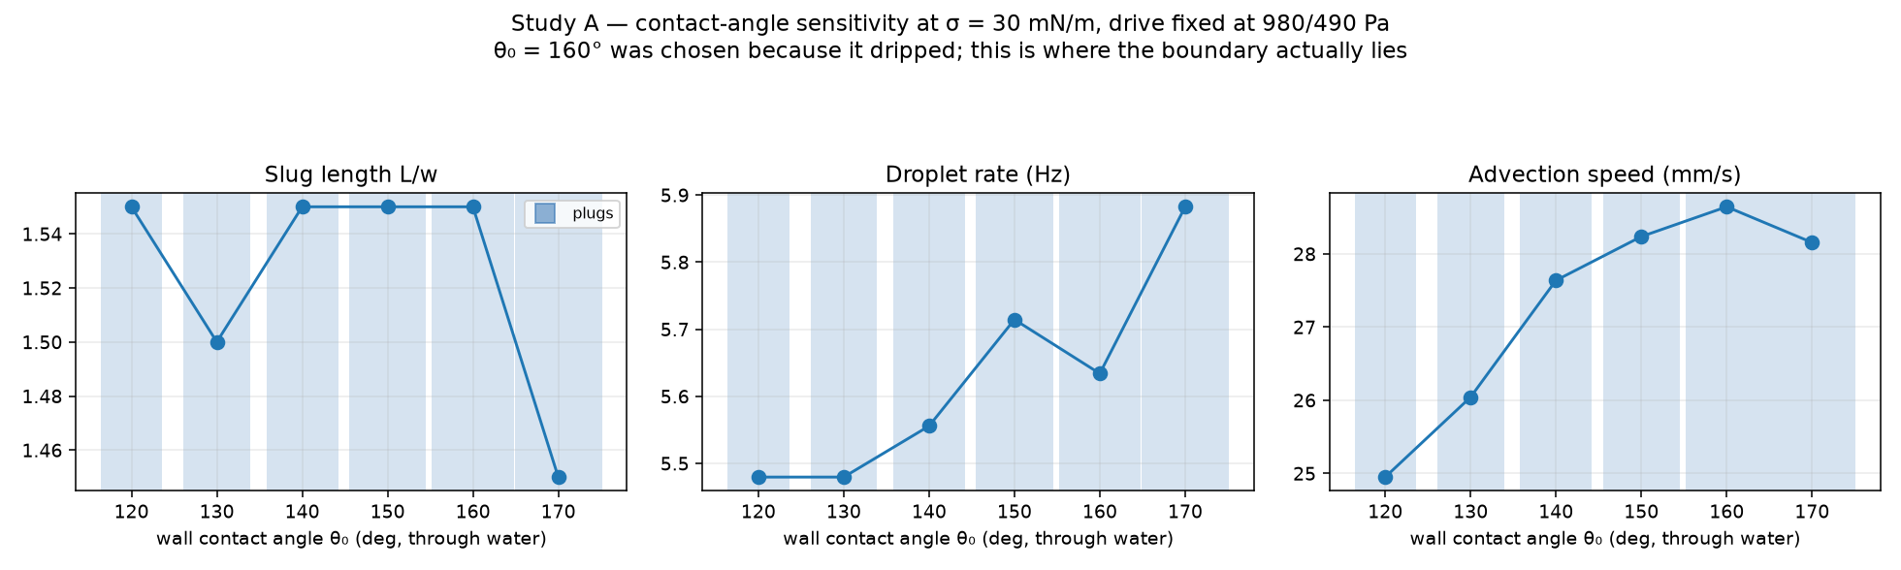
simulation/openfoam/results/wetting_2026-08/A_theta.png
