a-bissell/microfluidic-causal-chamber/simulation/openfoam/results/wetting_2026-08/B_sigma_fixedP.png

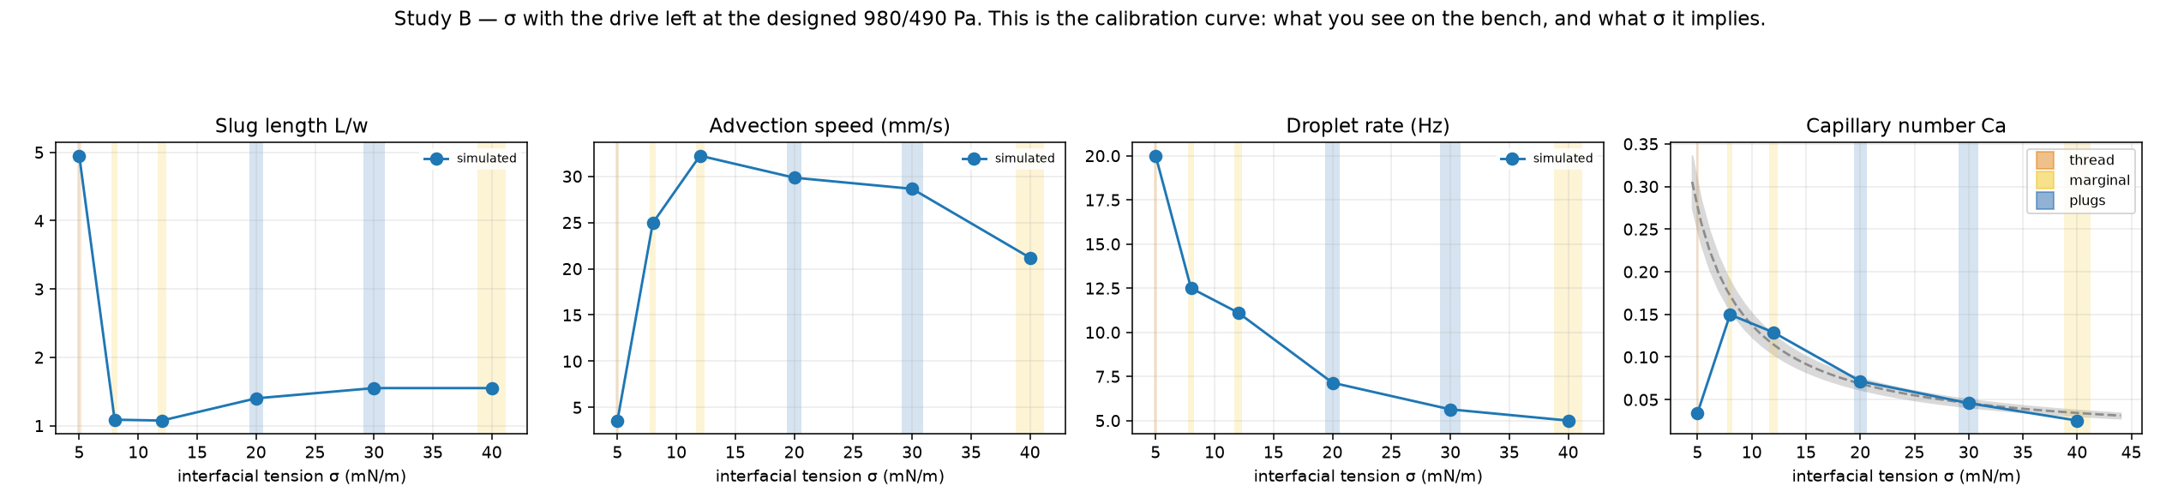
simulation/openfoam/results/wetting_2026-08/B_sigma_fixedP.png
