a-bissell/microfluidic-causal-chamber/simulation/openfoam/results/wetting_2026-08/C_sigma_scaledP.png

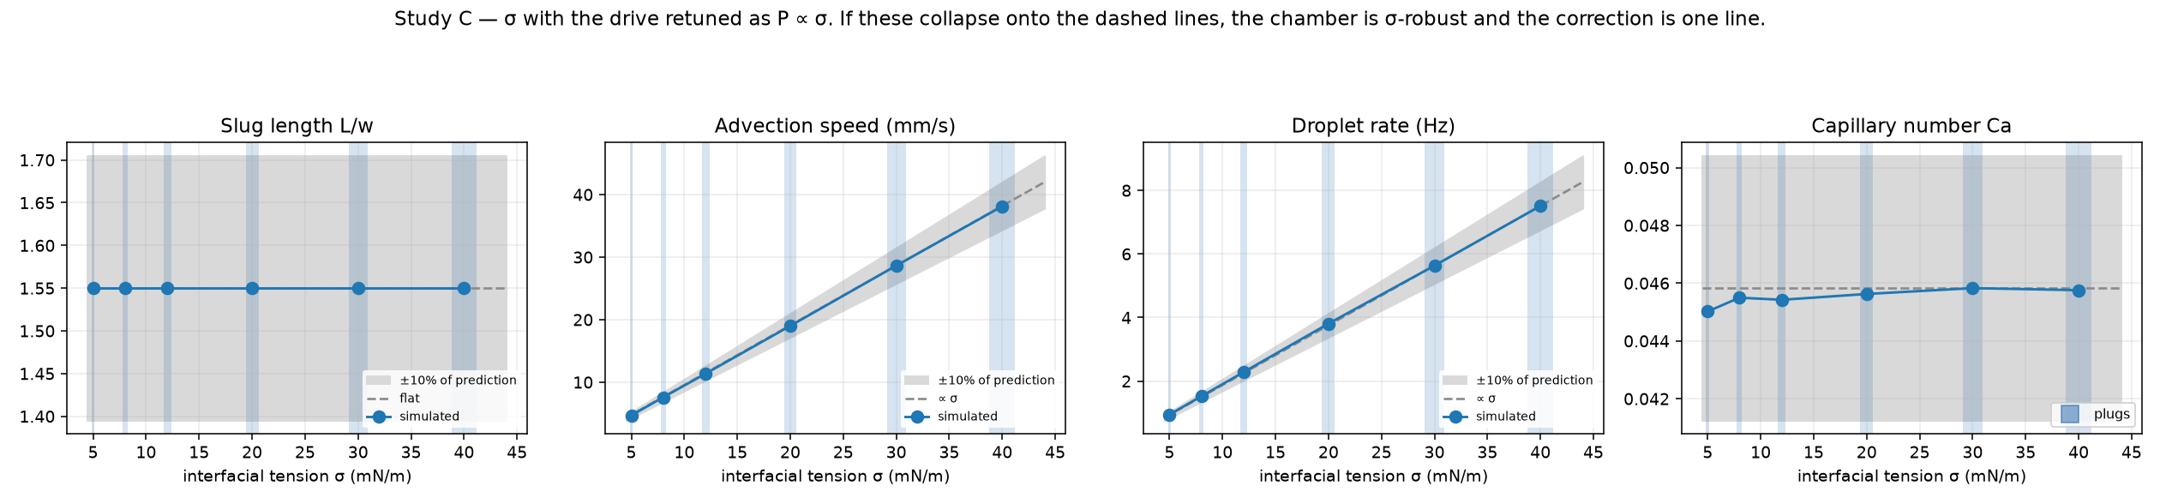
simulation/openfoam/results/wetting_2026-08/C_sigma_scaledP.png
