a-bissell/microfluidic-causal-chamber/simulation/openfoam/results/wetting_2026-08/D_3d_theta.png

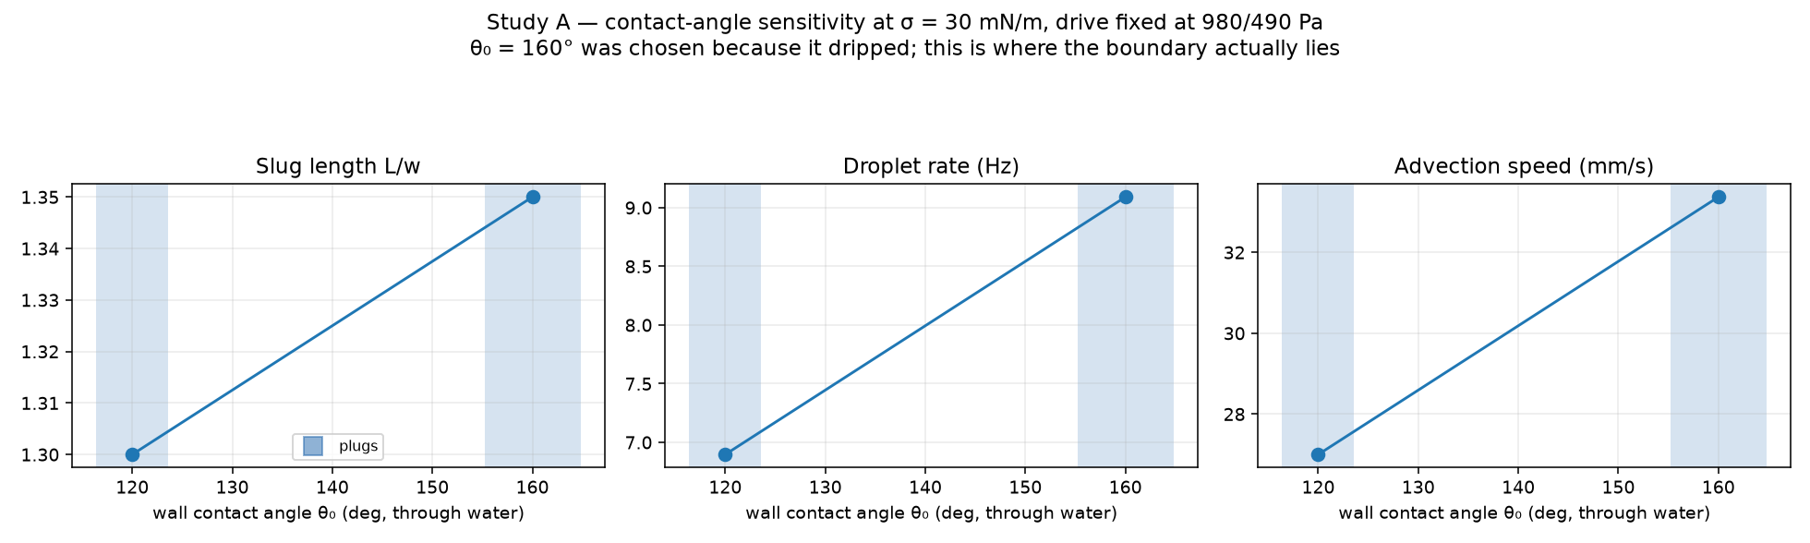
simulation/openfoam/results/wetting_2026-08/D_3d_theta.png
