a-bissell/microfluidic-causal-chamber/simulation/openfoam/results/window600_2026-07/window_map.png

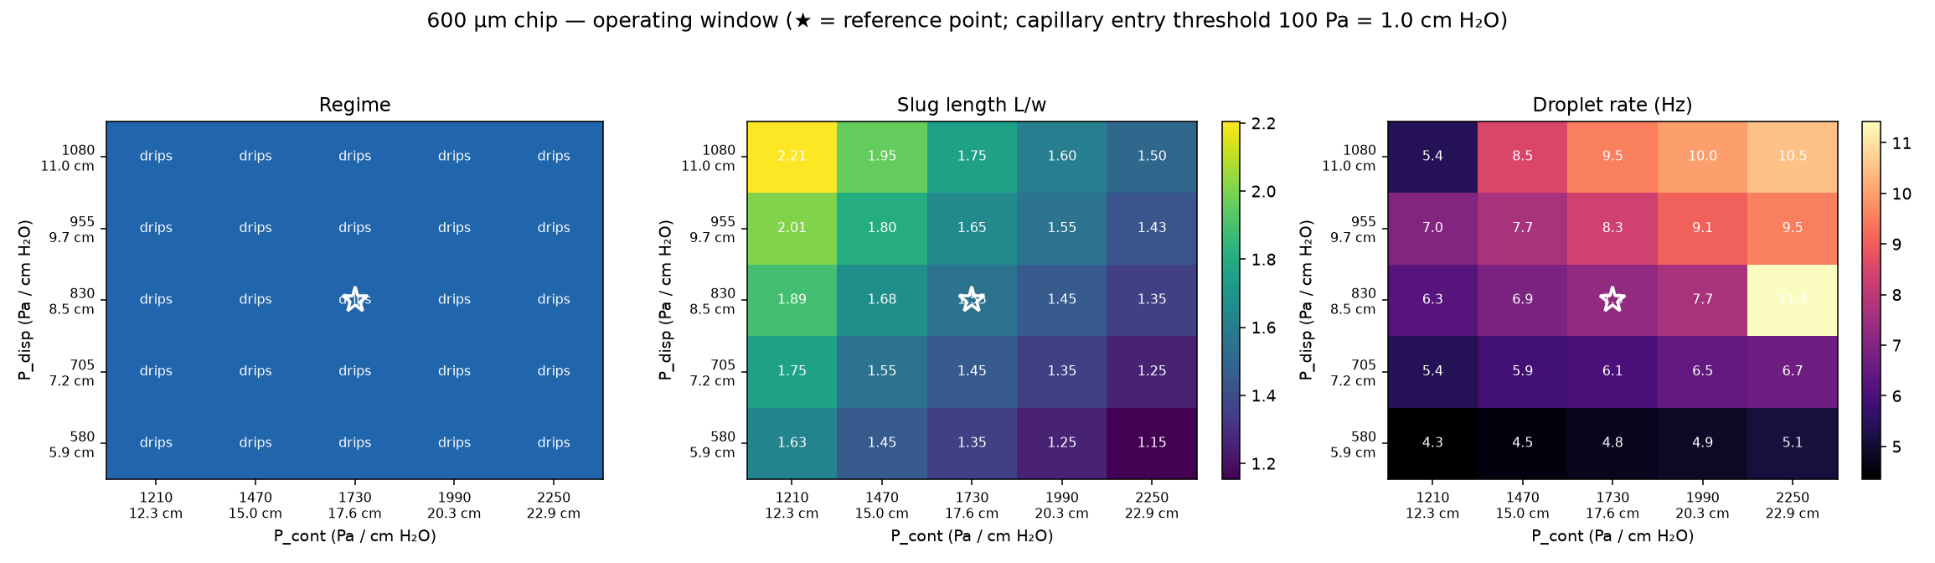
simulation/openfoam/results/window600_2026-07/window_map.png
