a-bissell/microfluidic-causal-chamber/(commit log)

2025-10-22 project plan update
    [variables.csv]
2025-12-21 feat: Add causal chambers documentation for Dynamo integration
2026-07-13 Fix T-junction BCs into droplet-forming regime; add verified sweep results
    The Dec 2025 case produced no droplets: 50/30 kPa inlets gave Ca ~ 1.9
    (need <~ 0.02) and a junction pressure above the water inlet's, so water
    inflow stalled; theta0=120 let water sit as a stable wall film.
    - Velocity inlets (oil 20 mm/s, water 10 mm/s -> Ca 0.032, q 0.25),
    theta0 160, dt capped below the capillary limit
    - Dual ESI/Foundation solver dicts (cAlpha, div(phirb,alpha), stress term)
    - Allrun falls back to foamRun (OF11) and exports legacy VTK
    - extract_droplets.py: real times from time dirs (filenames are iteration
    indices, not seconds); crossing-based frequency counter
    - README: corrected BC table a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
    [sweep_results.csv]
2026-07-13 Remove stale VTK output from the failed Dec 2025 run; ignore run artifacts
    The 87 MB of tracked VTK files showed the broken stratified-flow result
    (no droplets) and predate the BC fix. Solver outputs are regenerable and
    now gitignored; curated summaries live under results/.
2026-07-13 Add tjunction_2d_serpentine: pressure-driven case with inlet resistors
    Long narrow resistor channels upstream of each inlet (the 2D equivalent
    of a real chip's serpentine feeds) carry most of the driving pressure
    drop, fixing the razor-thin pressure operating window found in the
    sweep pilots: the operating point moves to controller-realistic values
    (P_cont = 13 kPa, P_disp = 3 kPa), water sensitivity drops to
    ~0.8 mm/s per 100 Pa, and the capillary-breach surge is bounded at
    ~6 mm/s instead of gushing.
    blockMeshDict is generated by gen_blockmesh.py (20 conformal blocks,
    5,500 cells; geometry parameterized). Verified in Docker (interFoam
    v2306): periodic droplet train at 16.7 Hz, L/w = 1.25,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
2026-07-13 Add pressure-actuated sweep results (serpentine case, 3x3 grid)
    All 9 (P_cont, P_disp) cells form periodic droplet trains at
    controller-realistic pressures, confirming the resistor design opens a
    wide operating window. Slug length and droplet speed respond
    monotonically to both actuators - the ground-truth P -> Q -> droplet
    mechanism as response maps. Frequency metric caveat documented.
    [psweep_results.csv]
2026-07-13 Add portable Docker-based sweep driver and analyzer
    sweep_pressure.py generalizes the ad-hoc 2026-07 sweep scripts: CLI
    grid/concurrency/paths, optional per-repeat actuation noise (seeded),
    dry-run mode, and a WSL2 /mnt-path warning. analyze_pressure_sweep.py
    extracts per-case droplet metrics, renders response maps, and exports a
    causal-chamber-schema causal_dataset.csv.
    Review fixes on the drafts: resolve the case path for the Docker mount
    (relative --output-dir previously failed), mark sweep rows as
    observational (actuation noise is not a do-intervention), and guard the
    map aggregation when no case yields detached droplets. Smoke-tested
    end-to-end in Docker (1-case run + analyzer, repeats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
2026-07-13 Add protocol-driven time-series runs (SET/WAIT/MSR analog)
    protocol_run.py builds chains whose inlet pressures follow a
    piecewise-constant schedule (uniformTotalPressure time tables): each
    chain tours the actuator grid in seeded-random order (or samples
    uniformly), paying the startup transient once and producing
    actuator-labelled time series in the wt_walks/lt_walks dataset shape -
    the raw material for changepoint detection and temporal causal
    discovery. analyze_protocol_run.py tags every output frame with the
    active protocol segment and phase, computes per-setpoint droplet
    metrics from measure windows only, and exports the full time series.
    Verified with a 2-setpoint smoke chain in Docker: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
2026-07-13 Add tjunction_2d_mill: digital twin of the millable 400 um chip
    Rescales the validated droplet regime (Ca = 0.032, q = 0.25) to feature
    sizes the Makers-Guide PMMA workflow can fabricate: 400 um channels from
    a single 1/64" endmill, on-chip 46 mm oil serpentine, and water feed
    resistance supplied by ~31 cm of 0.3 mm-ID tubing (modelled as an
    80 um x 27 mm channel with identical dP). Operating point lands at
    P_cont ~ 3.9 kPa / P_disp ~ 1.8 kPa - hydrostatic-column and
    balloon-rig territory - with ~9 Hz, ~540 um slugs at ~25 mm/s, easily
    imaged at 60 fps. Mesh (10 blocks, 9,440 cells) is checkMesh-clean;
    solver verification queued behind the running baseline sweep.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
2026-07-14 Add 5x5x3 overnight pressure dataset (75/75, monotonic response maps)
    First full MCC dataset from the serpentine case: droplets in all 75
    cases despite ~2% actuation noise, slug length and droplet speed
    monotonic in both actuators across every row/column of the 5x5 grid,
    median within-cell CV 2.2% over the 3 repeats. causal_dataset.csv is
    the causal-chamber-schema export and the mf_tjunction seed candidate.
    [causal_dataset.csv, results.csv]
2026-07-15 Add protocol-driven time-series runs (SET/WAIT/MSR analog)
    First time-series dataset: 6 chains, each a shuffled grid-walk tour of
    the same 3x3 pressure grid as psweep_2026-07 (9 setpoints/chain, 0.6 s
    sim time, ~9.4h on 6-way Docker concurrency). All 54 setpoint-segments
    produced droplet metrics.
    Cross-checked against the independent cold-start pilot at the same 9
    pressures: median |L/w difference| = 0.7% (max 11.9%, one point) -
    mid-schedule measurements after only a 15 ms settle window agree with
    fully independent simulations to ~1%. Frequency is documented as
    unreliable in this run (50 ms measure window is sub-period at the
    slowest corner); slug length is unaffected since it's read from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
    [protocol_results.csv, timeseries.csv]
2026-07-16 Verify tjunction_2d_mill: first solve, reference point + 25-case sweep
    The millable-chip digital twin had a checkMesh-clean mesh but had never
    actually been solved. Reference-point run (3.9/1.8 kPa) confirms the
    hydraulic design math: droplets form and exit cleanly, slug length
    600 um (predicted ~540, +11%), speed 28.3 mm/s (predicted ~25, +13%),
    frequency 11.1 Hz from 3 hand-tracked formation events (predicted ~9,
    +23%). A 25-case 5x5 operating-window sweep at +-18% around the
    reference point follows: all cells form droplets, L/w and speed
    perfectly monotonic across every row and column.
    Along the way, found and fixed a real bug: extract_droplets.py and
    analyze_pressure_sweep.py hardcoded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
    [causal_dataset.csv, results.csv]
2026-07-16 Add --dx to serpentine mesh generator for convergence checks
    Cell counts were hand-tuned constants matching DX=7.5 um with no
    programmatic link to the DX variable, so there was no way to generate
    a genuine refinement of the same mesh design without redoing the
    tuning by hand. Cell counts now scale from the DX=7.5 base values by
    BASE_DX/DX; grading ratios are resolution-independent and unchanged.
    Default invocation (no --dx) reproduces the committed blockMeshDict
    byte-for-byte (verified via git diff). --dx 5.0 generates a 2.29x-cell
    refinement (12,614 vs 5,500 cells) used for the mesh-convergence check
    on the pressure sweep results.
2026-07-16 Mesh convergence check (5um vs 7.5um): solver solid, extraction hit limits
    9-point check on tjunction_2d_serpentine at the same pressures already
    published in psweep_2026-07/protocol_v1_2026-07 (a subset of
    psweep5x5_2026-07's grid). gen_blockmesh.py --dx 5.0 gives a genuine
    2.29x-cell refinement of the same mesh design. All 9 solves succeeded;
    droplets form at every point, same regime as 7.5um - no evidence of a
    resolution-driven regime change.
    Quantitative L/w comparison is honestly inconclusive. The existing
    static-window extraction produced clearly wrong numbers on first pass
    (L/w up to 2.57, non-monotonic) - traced to still-attached, still-
    growing water threads passing through the sam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
    [results_default_filter_UNRELIABLE.csv]
2026-07-17 Mesh convergence rerun at 2x endTime: 4/9 points now solid, 5/9 open question
    Doubling endTime (0.06 -> 0.12s) on the same 9 cases resolved most of
    the earlier ambiguity from catching cases mid-formation-cycle. 4 points
    now have 3+ independent, near-identical mature-length readings each
    spanning 40+ frames, agreeing with the published 7.5um psweep5x5 data
    to within 3-19% (best agreement at high pressure, as expected - faster
    pinch-off is less sensitive to numerical differences near a marginal
    regime).
    The other 5 points (all P_disp=3.6 kPa, plus pc10k_pd3k - the
    highest-total-flow cases) surfaced something new: repeated detections
    at length ~997.4um, essentially the full outlet channel. Two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
2026-07-18 Extended-outlet recheck resolves the 997um signature; flag psweep5x5 top row
    Both suspect cases rerun at 5um with the outlet tripled (--l-outlet
    3000). The 997um full-channel signature and the climbing-length trend
    are both gone: they were droplets crowding and coalescing in the
    too-short measurement domain, not chamber physics.
    What replaced them is cleaner and more interesting:
    - pc16k_pd3.6k: three tracks all at exactly 165.0um (+-0.1um, 36-107
    frames each) - a stable monodisperse train; the growing-slug
    hypothesis is refuted there.
    - pc10k_pd3.6k: clean alternating large/small emission (478, 270, 550,
    245, 532um in formation order) - classic period-doubled droplet
    emission. The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
2026-07-18 Add droplet-formation filmstrip to the mill-twin results
    Rendered from the reference-point verification run's VTK output
    (nearest-neighbor resampling handles the graded water-leg cells).
    Shows the full cycle: column descent, tongue blocking the junction,
    first ~600 um slug detaching at ~90 ms, steady rhythm thereafter.
2026-07-18 Add mill chip v1 fabrication layout (1x3 inch blank)
    Generator emits both the CAM-ready SVG (mm units, one group per
    operation: outline / channels / port thru-holes / reference pads) and a
    dimensioned preview PNG from the same coordinates. Design carries over
    from the sim-verified tjunction_2d_mill twin: 400um channels, 48mm oil
    feed (which unfolds completely straight on a 3" blank - no serpentine
    folding, one continuous pass), 6mm outlet run, water resistance
    off-chip via 31cm of 0.3mm-ID tubing. Deviations from the sim domain
    and their pressure cost are annotated in the script docstring (both
    are <=3% of P_cont).
2026-07-18 Add tjunction_3d_mill: 3D fidelity twin of the millable chip
    First 3D case that is actually tractable on desktop hardware: the mill
    geometry's 400um channels permit 20um cells, and a half-depth domain
    with a mid-plane symmetry boundary halves the bill again (84k cells vs
    173k for the older 150um tjunction_3d). Junction region only, velocity
    inlets at the verified 2D reference point (Ca=0.032, q=0.25) - a 2D-vs-
    3D fidelity check does not need the feed hydraulics, and x coordinates
    match tjunction_2d_mill so the droplet extractor's geometry parameters
    carry over unchanged.
    Purpose: measure what the 2D shortcut costs. Real square channels have
    corner gutters - the four corners a droplet's rou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
2026-07-19 3D fidelity check: 2D length maps certified, rhythm 2.4x faster in 3D
    First 3D solve of the project (tjunction_3d_mill, 8.25h at 6-way MPI on
    the mini). Seven complete droplet tracks, six at identical 620um length
    on a metronomic 37.5ms beat. Versus the 2D twin at the same operating
    point: slug length +3% (2D length/response maps certified for bench
    use), droplet speed x1.43 (40.0 mm/s), frequency x2.4 (26.7 Hz) - the
    corner-gutter effect, measured. Self-consistent to ~3%: mass-
    conservation slug volume matches measured geometry, and speed is 1.33x
    superficial velocity (the classic square-channel bypass ratio).
    Hardware consequences folded into the mill READMEs: expect ~620um slugs
    at ~27 H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
2026-07-19 Update mill-chip first-light expectations with 3D-corrected numbers
    620um slugs at ~27 Hz and ~40 mm/s (not the 2D twin's 11 Hz / 28 mm/s),
    and a >=120 fps camera recommendation to match the corrected rhythm.
2026-07-25 Cyclicity test: actuation mode determines the causal graph
    Tests a claim raised in discussion - that pressure sources make flow
    rates emergent (cyclic graph) while flow sources impose them (near-DAG),
    on the same chip. We had already built both kinds of case for hydraulic
    convenience without noticing they were different causal structures, so
    this needed no new simulation.
    Confirmed, and the effect is large. Pressure-driven: water-inlet flux
    swings 41% peak-to-peak on a 22.3ms cycle; the independently-measured
    droplet formation period is 22.0ms, so the inlets are clocked by the
    droplets (1.4% agreement). Q_oil and Q_water correlate at +0.998 with
    zero lag - not mutual causation but a shared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
    [flux_pressure_driven_pc13k_pd3k.csv, flux_summary.csv, flux_velocity_driven_mill3d.csv]
2026-07-25 Design doc: autonomous sim -> mill -> test research station
    Exploration of an end-to-end bench cell that simulates a chip geometry,
    mills it, plumbs it, tests it, and reports the sim-to-real gap unattended.
    Key framings, argued in the doc:
    - Three loops (pressure setpoints / geometry / failure recovery) with
    different periods; the science lives in the inner loop, so build
    inner -> outer -> robot. The robot's real job is unattended recovery.
    - The robot only handles dry rigid parts; fluid connections live in a
    permanent reusable manifold. This removes the hardest manipulation
    task (autonomous plumbing) from the critical path.
    - Sim and bench must share one measurement code path, or t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
2026-07-25 Demonstrate sampling-rate pathologies on the flux data
    Decimates the 1ms pressure-driven flux record to show, rather than argue,
    that what an analyst concludes depends on sampling rate - and that the
    two real measurement modalities fail in opposite directions.
    Subsampling (strobe / short-exposure camera): variance survives but is
    relocated. The true 44.8 Hz cycle appears as 38.5, 17.7, then 5.2 Hz as
    the interval goes 12, 16, 20 ms - at 20 ms a 45 Hz cycle masquerades as a
    slow 5 Hz mode the chamber does not have.
    Aggregation (integrating sensor / long exposure / RC-filtered line): the
    cycle is hidden instead. Water-inlet CV collapses 9.9% -> 2.2% and the
    chamber looks like a steady map wi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
    [sampling_rate_sweep.csv]
2026-07-25 Same-geometry A/B confirms cyclicity result; correct the r~1 overclaim
    Controlled version of the cyclicity test: identical mesh, endTime and
    sampling, with diff confirming only 0/U and 0/p_rgh differ. Velocity-arm
    inlet speeds set from the measured mean flux of the pressure arm, so both
    arms sit at the same operating point.
    Headline is stronger than the first pass: the arms produce essentially
    identical droplets (188 vs 180 um, formation gap 21.0 vs 21.0 ms, 45.0 vs
    44.6 Hz) while their inlet flows differ completely (9.9% / 2.2% CV vs
    0.00% / 0.00%). An observer measuring only droplets cannot tell the arms
    apart; one with flow sensors distinguishes them instantly - two causal
    structures beh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
    [ab_flux_pressure_arm.csv, ab_flux_velocity_arm.csv]
2026-07-30 v2 chip design: 600 um channels, both resistors off-chip, guide diagrams
    Replicability-driven redesign. The droplet regime is set by Ca =
    mu*U/sigma, which has no length in it, so widening the channel at fixed
    velocity preserves the physics while buying fabrication margin: endmill
    stiffness goes as d^4, making a 0.6 mm tool ~5x stiffer than the 1/64"
    the v1 design required. Drive pressures fall as 1/w^2 to 1.7 kPa oil /
    0.83 kPa water - 18 cm and 8 cm water columns instead of 40 and 18.
    Gravity stays negligible (Bond 0.005 at 600 um; capillary length is
    8.7 mm), helped by water and silicone oil being nearly density-matched.
    Both flow resistors move off-chip into tubing (oil: 12 cm x 1.0 mm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
2026-07-30 Scale-up verified: 600 and 800 um reproduce the chamber within 4%
    Runs the millable-chip twin at 600 and 800 um and compares against the
    verified 400 um reference. The replicability motivation: endmill stiffness
    goes as d^4, so a 0.6 mm tool is 5x and a 0.8 mm tool 16x stiffer than the
    1/64" the original design needs.
    Ca contains no length, so holding the mean velocity fixed should give
    geometric similarity at any width. It does. Anchoring every prediction on
    the 400 um point, so 600 and 800 are out-of-sample:
    L/w 1.500 / 1.554 / 1.550 (predicted flat)
    speed 28.09 / 28.04 / 28.46 mm/s (predicted flat)
    f 11.43 / 7.41 / 5.71 Hz (predicted 1/w, worst error 2.8%)
    Q_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
    [flux_400um.csv, flux_600um.csv, flux_800um.csv, summary.csv]
2026-07-31 600 um operating window: 25/25 cells drip at +/-30%, no edge found
    Answers the question left open by scaleup_2026-07: the capillary entry
    threshold is 2*sigma/w, which grows as a FRACTION of drive pressure with
    width (8.3% at 400 um -> 12% at 600 -> 15.3% at 800), so a wider chip
    might be easier to machine but fussier to actuate. If true the hardware
    guide has to say so.
    It isn't. 25 cases, 5x5 at +/-30% about the 600 um reference (deliberately
    wider than the +/-18% used at 400 um, which returned 25/25 and so never
    found its own edge either). Every cell drips. The window is at least
    12.3-22.9 cm of oil against 5.9-11.0 cm of water, and its edges are
    outside the sweep. At the lowest P_disp t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
    [window_results.csv]
2026-08-02 Corrected 3D fidelity check at 800 um: gutters cost x0.87 length, x1.59 rate
    Replaces the withdrawn mill3d_2026-07 correction factors with a measurement
    taken against a properly matched baseline.
    The 2026-07 run had two confounds, not the one already identified:
    - operating point: 0/U ran q = 0.50 against a 2D reference measured at
    q = 0.28, i.e. 79% more water;
    - actuation mode: velocity-driven 3D compared against pressure-driven 2D,
    which the cyclicity work established are different causal structures.
    Both removed. The operating point is now DERIVED from the measured 2D
    fluxes (Q_oil 12.694, Q_water 3.706 uL/s -> U = Q/w^2 -> 0.019834 /
    0.005791 m/s, q = 0.292, Ca = 0.032) wi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
    [metrics.csv]
2026-08-02 Render the 3D interface: droplet formation over one full cycle at 800 um
    Adds scripts/render_droplet_3d.py -- marching cubes on alpha.water, lit and
    shaded, inside a wireframe of the channel -- and the resulting filmstrip and
    animation for the corrected 800 um 3D run. Every other figure in the project
    shows the droplet as a 2D field, which is the representation the 3D fidelity
    check exists to question.
    The data was already sufficient: 121 frames at 5 ms over 0.6 s, ~22 frames
    per 110 ms formation cycle, five complete cycles to choose from.
    Four pipeline details that each produce a wrong or unreadable picture rather
    than an error, documented in the script and the README:
    - the half-depth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
2026-08-02 Add tjunction_3d_encoder: 3-dye cross-merge encoder twin
    Digital twin of an encoded-droplet chip. Three dye streams merge upstream
    of the T-junction and each droplet's composition c_i = Q_i/sum(Q) is a
    symbol. The case tests one claim: that a droplet's integrated dye content
    equals the commanded flow fraction, so integrated readout is
    mixing-insensitive and no on-chip mixer is needed.
    That claim has a 3D-only hole. mill3d800_2026-08 measured corner intrusion
    in the water leg (min cell-centre alpha 0.75 across x, 0.83 across z) and a
    slug-bypass ratio of 1.307 in 3D against 1.118 in 2D. If the continuous
    phase intrudes at the corners, the slug samples the core preferentially
    rather than the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
2026-08-02 Fix wall wetting: encoder jetted instead of dripping
    The first 2D run of the encoder case produced no droplets. It meshed
    cleanly, ran cleanly, and conserved phase to machine precision -- the
    answer simply never appeared. Water entered at the top of the main channel
    and rode the wall as a jet from x=2020 out to x=4940 um as a single
    connected cluster, never blocking the junction, so the oil never had to
    squeeze it.
    Cause: the generator emitted zeroGradient for alpha on walls, which is
    neutral wetting (90 deg). tjunction_2d_mill and tjunction_3d_mill both
    carry theta0 = 160 deg with a comment recording this exact failure -- "160
    deg keeps the water thread off the walls so it can neck and pin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
2026-08-02 Guard against analysing a run with the wrong geometry manifest
    gen_blockmesh.py writes geometry.json to a fixed path, and the 2D baseline
    and 3D case share one generator, so generating the second variant silently
    overwrites the first's manifest. Pairing a 3D manifest with 2D output
    analyses without complaint -- the commanded composition and outlet window
    still look sane -- while reporting wrong volumes under a wrong
    dimensionality label.
    extract_droplet_dye.py now cross-checks the manifest's cell count against
    the VTK output and exits with the likely cause. The two variants differ by
    the depth cell count (68000 vs 6800 at the defaults), so the check is
    unambiguous. README run plan now says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
2026-08-02 Update encoder cost estimates to measured rate
    2D baseline measures 3,800 s per simulated second on 4 cores at
    maxDeltaT 1e-5, so ~50 min for the 0.8 s run rather than the ~37 min
    estimated at the previous looser timestep. 3D extrapolated on cell count
    (x10) to ~8 h on 4 cores, flagged as an upper bound since the pressure
    solve does not scale quite linearly.
    Also records the geometry.json overwrite hazard in the run plan.
    Claude-Session: https://claude.ai/code/session_01TyhDJLkVtama5ubghmbVMG
2026-08-02 Record the open pinch-off problem in the encoder README
    The 2D encoder case still produces no detached droplet. Correcting the
    contact angle moved it a long way in the right direction -- water went from
    a thin wall-riding jet (34% of channel height, unbroken to 4.9 mm) to a
    compact body filling 45-65% of the channel near the junction -- but at
    t = 0.185 s the thread is still attached, 2.5 mm long against an expected
    1.24 mm slug, and growing at ~27 mm/s.
    Documented rather than left implicit, with the three candidate causes in
    test order. The leading one is the OpenFOAM build: local verification used
    the Ubuntu 24.04 package (ESI v1912) while this project's verified results
    came from v2306.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
2026-08-02 Revert encoder to interFoam + passive scalars: multiphase does not drip
    multiphaseInterFoam was chosen so each dye would be a MULES-conserved phase,
    removing the differential-leakage confound at the source. It does not form
    droplets. Three runs settled it:
    verified tjunction_3d_mill geometry + interFoam -> drips, L = 1400 um
    THIS geometry + interFoam -> drips, L = 1240 um
    THIS geometry + multiphaseInterFoam -> no pinch-off
    The middle row is the one that matters. This exact mesh, these exact
    velocity BCs and this exact contact angle reproduce the verified 800 um 2D
    slug length of 1240 um from results/scaleup_2026-07 on the nose. So the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
2026-08-02 Verify the cross-merge against the chamber on all four observables
    The earlier claim was that this geometry reproduces the verified 800 um 2D
    slug length. Running the isolation case out to 0.40 s lets all four
    observables be checked, not just length, against
    results/scaleup_2026-07:
    slug length 1240 um -> 1265, 1283 um (+2.7%)
    period 175 ms -> 170 ms (-2.9%)
    droplet rate 5.71 Hz -> 5.88 Hz (+3.0%)
    advection speed 28.46 mm/s -> 30.7, 32.6 mm/s (+8%)
    All inside the +/-10% band used elsewhere in this project and well inside
    the 3-19% spread the mesh convergence study found.
    This is the premise the encoder rests on: adding three inl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
2026-08-03 Add dye-transport pre-flight check
    The three scalarTransport function objects are the one unverified link in
    this case, and they have never been run anywhere: the local verification
    build aborts on any function object. Everything else -- geometry, droplet
    formation, analysis statistics -- is verified.
    check_dye_transport.py closes that gap in two minutes instead of eight
    hours. It tests three things, and the middle one is why it exists:
    1. the dye fields are present in the output;
    2. they have CHANGED since t=0;
    3. sum(dye_i) == alpha.water over wet cells.
    Check 2 catches the dangerous failure. If a function object fails to load,
    some builds abort but others warn and carry on -- and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
2026-08-03 Restore tjunction_3d_mill's generated mesh to its committed default
    Running the 2D-vs-3D control test regenerated tjunction_3d_mill's
    blockMeshDict and setFieldsDict in place, as
    `gen_blockmesh.py --w-main 800 --two-d`. Those files are generated but
    committed, so the side effect landed in the branch: a verified case's
    checked-in mesh silently became the 800 um 2D variant instead of its
    documented 400 um 3D half-depth default (z extent 200 -> 800 um, y
    400 -> 800 um).
    Anyone running that case afterwards would have got a different geometry
    than its README describes, with nothing to indicate it. The encoder work
    needed nothing from tjunction_3d_mill except a one-off control run, so both
    files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
2026-08-08 Encoder: fix the dye readout, restore multiphase, verify the 2D null
    The encoder's composition readout is measured end-to-end in 2D for the first
    time. The passive-scalar method (interFoam + three scalarTransport dyes) does
    not work; multiphaseInterFoam does, and its 2D null passes. Along the way four
    analysis bugs and one false solver decision are corrected.
    Findings (results/encoder_dye_2026-08):
    - Passive scalars leak ~20% of the dye into the oil with no coupling to alpha,
    so composition never converges -- the core-vs-wall signature changes sign
    between dx 40 and 60 um. Refinement cannot fix it (leakage ~ dx^0.49).
    Advecting the dyes on the water flux was tried and is worse (non-c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
    [droplet_dye_dx40.csv, droplet_dye_dx60.csv, droplet_dye_multiphase_2s.csv, droplet_dye_multiphase_6p5s.csv]
2026-08-08 Encoder: satellites are a cAlpha artifact, not the noise driver
    Follow-up to the 2D verification. Establishes what the multiphase satellite
    shedding is, and — the question that mattered for the 3D budget — whether
    removing it reduces the per-droplet noise that sets n ~ 34. It does not.
    The satellites are a numerical artifact of the global cAlpha compressing the
    three same-fluid water-water pairs (sigma = 0 between them). Four lines:
    - rate scales with cAlpha: 1.93 -> 0 -> 0 sat/slug at cAlpha 1.0/0.5/0.0
    over matched 0.4 s runs;
    - composition is single-lamina (97% > 0.6 one dye) where a physical capillary
    satellite would carry a mixed cross-sectional slice;
    - only the wall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
    [droplet_dye_multiphase_c05_2s.csv]
2026-08-08 Add nightly chunked-run harness for the 3D multiphase encoder
    The 3D run (~4 s sim to reach n~34) is ~55 h on the M4's 4 P-cores -- too long
    for one sitting, and the machine is needed during the day. OpenFOAM checkpoints
    natively, so this splits it into overnight sessions.
    simulation/openfoam/nightly/:
    run_tonight.sh - start fresh or resume from last checkpoint, detached,
    idempotent (no-op if already running)
    stop_clean.sh - stopAt writeNow -> final checkpoint + clean exit;
    docker stop fallback after 5 min
    morning_check.sh - reconstruct new times, extract droplets, print
    core-vs-wall +/- SE and a decisive-yet verdict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
2026-08-10 Refocus repo as standalone Microfluidic Causal Chamber (MCC)
    This repo began as a fork of juangamella/causal-chamber (the datasets repo)
    with microfluidics work layered on top. Strip it down to a standalone MCC
    project that references the upstream Causal Chambers rather than vendoring it.
    Removed (upstream or off-topic):
    - 18 wind/light-tunnel datasets (lt_*, wt_*) — live upstream only now
    - hardware/datasheets/ (17 MB of tunnel sensor PDFs) + empty hardware
    placeholders (arduino, blueprints, control, electronics)
    - docs/ (Dynamo investment-management notes, unrelated to microfluidics)
    - MICROFLUIDIC_CHAMBER_SUMMARY.md (stale Oct-2025 planning doc)
    - .github/FUNDING.yml (sponsored the u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
    [lt_camera_validation_configs.csv, lt_validation_configs.csv, variables.csv, wt_pc_validation_configs.csv, wt_standard_validation_configs.csv]
2026-08-10 README: add 3D droplet-formation animation and 2D drip-cycle filmstrip
    Lead with the 3D interface GIF (interFoam VOF, 800 um milled-chip twin) as
    the hero, and add the 2D 0-50 ms pinch-off filmstrip in the Simulation
    section. Both assets are already tracked under simulation/openfoam/.
2026-08-10 Remove vestigial simulation webapp
    The webapp predated the July-August sim rework and had drifted out of usable
    sync with it: it shells out to Foundation-v11 `foamRun -solver incompressibleVoF`
    (the project standardized on ESI v2306 interFoam/multiphaseInterFoam in Docker),
    knows only a single hardcoded 2D template, drives pressure BCs the verified
    cases replaced with flux-derived velocity BCs, and computes results through its
    own superseded parser (droplet detection was an empty stub) with none of the
    analysis fixes or the dye/encoder concept.
    Removing it wholesale; a fresh viewer aligned to the current 2D/3D cases will
    replace it.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
2026-08-10 Add a static results viewer (2D field playback, 3D isosurface, metrics)
    Replaces the removed webapp with a dependency-free, backend-free viewer under
    simulation/openfoam/viewer/ — plain index.html + styles.css + app.js, data
    loaded via <script> so it works from file:// too. Three tabs:
    - 2D T-junction: real interFoam alpha.water field over a drip cycle, resampled
    to a regular grid, with play/scrub, colormap, and interface-highlight.
    - 3D droplet: the rendered 800um isosurface loop; hooked to accept an
    interactive isosurface export later (3D field data is multi-GB, out of repo).
    - Metrics: droplet L/w and formation frequency vs flow ratio, grouped by Ca,
    from results/sweep_2026-07.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
2026-08-10 Remove the station/ design-exploration folder
    station/ held a single speculative design doc for an autonomous
    sim -> mill -> test -> gap research loop -- no hardware, no code, aspirational.
    Dropping it to keep the repo to built/in-progress work; also removes its row
    from the README what's-here table and from the MIT license scope line.
2026-08-11 nightly: make morning_check disk-safe
    A near-full internal disk filled during morning_check at t=2.04 s: reconstructPar
    + foamToVTK ran over all 6 fields and all times, ballooning past the free space
    and segfaulting foamToVTK. The checkpoints survived (solver had already stopped),
    but the analysis crashed on the truncated VTK.
    Fix: reconstruct/convert only the three water-phase fields the extractor needs,
    only the post-settle window (t >= 0.35 s), guard on <3 GB free (abort, don't
    fill), and drop the reconstructed root dirs after analysis (regenerable from the
    processor checkpoints; VTK + CSV kept). Cuts the transient footprint ~5x.
    First real 3D reading, for the record (n=14 at t=2.04 s):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
2026-08-12 Encoder 3D: no significant corner bias — the readout holds in 3D
    The result the whole encoder case was built to measure. 3D half-depth, 66k
    cells, multiphaseInterFoam, 4-rank MPI, run overnight in chunks via nightly/,
    to t=3.0 s.
    core-vs-wall = c2 - (c1+c3)/2 = -0.007 +/- 0.009 (n=23, 0.8 sigma)
    Consistent with zero and with the 2D null (-0.002). As n grew it moved TOWARD
    zero (-0.010 at n=14 -> -0.007 at n=23, significance 1.2 -> 0.8 sigma) -- a null,
    not an emerging effect. The tentative negative-sign hint at n=14 (centre lamina
    under-sampled, opposite the naive corner-gutter prediction) washed out, so it
    was noise; correctly not banked. The encoder's mixing-insensitivity holds in 3D: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
    [droplet_dye_3d_multiphase_n23.csv]
2026-08-12 nightly: note the 3D run is archived to the T7
    Completed run (n=23, no significant corner bias) moved to
    /Volumes/T7/robolab_runs/encoder_3d_mp/ to free the internal disk. Documents how
    to resume it (move back to internal; Docker can't bind-mount /Volumes/T7 without
    adding it to Docker Desktop file sharing).
2026-08-12 Add 3D coded-droplet visualization tooling + GIF
    Renders the encoder's 3D interface coloured by composition (dye1=R, dye2=G,
    dye3=B) -- the code visible on the droplet, which the mill renderer (solid-blue
    water) could not show.
    scripts/:
    render_encoder_3d.py - filmstrip / GIF of the marching-cubes interface,
    coloured by dye ratio. Adapted from
    render_droplet_3d.py (contours total water,
    paints composition on the surface).
    export_encoder_mesh.py - export interface mesh (verts, tris, per-vertex
    composition colour, normals) + channel wireframe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
2026-08-12 README: feature the 3D coded-droplet visualization
    Embed coded_droplet_3d.gif near the microfluidic-chamber section, linking to
    the encoder case and the encoder_dye_2026-08 write-up.
2026-08-12 Revise README with latest T-junction encoder results
    Updated the README to reflect the current status of the T-junction encoder's performance and findings from the 3D run.
2026-08-12 Plan: replace the kPa pressure-controller rig with hydrostatic actuation
    The plan's geometry section had been updated to 600-800 um, but the fluid
    handling, observation, protocol and budget sections still described the
    original 100-200 um build. The document was internally inconsistent and
    would have sent a builder shopping for the wrong hardware.
    Drive pressure scales as 1/w^2, so the scale-up moved the operating point
    out of regulator territory and into hydrostatic reach:
    400 um 3900 / 1800 Pa 40 / 18 cm H2O
    600 um 1730 / 830 Pa 17.6 / 8.5 cm
    800 um 980 / 490 Pa 10.0 / 5.0 cm
    2.2 now specifies 2x Mariotte bottles on motorised Z axes instead of
    Fluigent/Elvef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
2026-08-12 BOM: rewrite for the 800 um chip -- hydrostatic rig, and a hobby CNC suffices
    The BOM was still the 100-200 um shopping list. Beyond the stale specs
    already fixed in the plan, it actively contradicted the project's central
    replicability claim: it told the reader the hobby-CNC -> desktop-CNC quality
    jump was "huge, worth it" and specced 1/64" endmills, when the whole point of
    the 600-800 um scale-up was to remove that requirement.
    Endmill stiffness goes as d^4. 1/32" (0.794 mm) is a stock, cheap size and
    16x stiffer than 1/64". Depth-to-diameter is 1.0 at every scale, so the
    milling technique is identical -- two passes at 0.5xD -- and only the tool's
    fragility changes. The milling machine dr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
2026-08-13 Wetting sweep: contact angle does not gate droplet formation at 800 um
    The two fluid-property assumptions under every result in this repo had
    never been measured. sigma = 0.03 N/m carries no citation and sits at
    roughly the BARE water/silicone-oil value, which is a strange place to
    land for a 2 wt% Span 80 load. theta0 = 160 deg was, by its own comment,
    selected because 120 deg produced a wall film -- and then recorded in the
    risk register as "verified in OpenFOAM", which is circular.
    Study A (6 cases, 800 um, 2D, pressure-driven, sigma = 30 mN/m) sweeps
    theta from 120 to 170 deg. All six form plugs. L/w is flat to the
    resolution of the measurement -- every measured length is an exact
    multi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
    [A_theta_results.csv]
2026-08-13 Wetting cliff bracketed to 105-120 deg; sigma calibration curve; classifier fix
    Study A2 takes theta below 120 deg, where study A found no boundary:
    60/75/90/105 all produce a continuous thread, detection spanning 3960 um of
    the 4000 um outlet. Combined with study A, the cliff sits between 105 and
    120 deg. The claim in simulation/openfoam/README.md ("strongly oil-wet,
    theta0 >= 150") is therefore real but mislocated by ~45 deg -- and it is
    not merely "don't be water-wet" either, since neutral 90 deg also fails.
    Plausible PMMA-under-Span-80-oil values are 120-150 deg, above the cliff
    but not by much, so this is "worth measuring", not "stop worrying".
    Study B sweeps sigma at the designed 980/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
    [A2_theta_low_results.csv, B_sigma_fixedP_results.csv]
2026-08-14 3D spot-check: theta = 120 forms plugs with all four walls wetting
    The 2D studies applied theta0 to only two of four walls (frontAndBack is
    empty), which biases a 2D sweep toward finding contact angle unimportant --
    the exact conclusion it reached. Study D runs the test that closes that gap:
    theta = 120 vs 160 on the 44,000-cell half-depth 3D mesh, where the floor is
    a real wall and the ceiling its mirror. Velocity-driven, 6-way MPI, ~5 h
    each.
    Validity first: theta = 160 reproduces mill3d800_2026-08 essentially exactly
    -- L/w 1.350 vs 1.350, 9.0909 vs 9.091 Hz, 33.37 vs 33.50 mm/s. No
    configuration drift, so the comparison is controlled.
    Both form plugs. L/w 1.30 vs 1.35, one 40 um cell a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
    [A2_theta_low_results.csv, B_sigma_fixedP_results.csv, D_3d_theta_results.csv]
2026-08-14 Study C: retuning the head as P ~ sigma recovers the design point exactly
    Six cases, same sigma values as study B but with both columns scaled by
    sigma/30 and the clock rescaled by 30/sigma (if P ~ sigma then U ~ sigma, so
    the period goes as 1/sigma; a fixed endTime would show fewer droplets at low
    sigma purely because the run ended).
    All six give plugs at L/w = 1.550 -- identical across an 8x range in sigma
    and an 8x range in column height, 1.66 to 13.32 cm. Speed and rate track the
    ~sigma prediction to better than 1.8%.
    The contrast with study B is the point. At the designed 10.0/5.0 cm head,
    sigma = 5 produces a continuous thread with nothing detaching at all, and
    8/12 produce barely-pl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
    [C_sigma_scaledP_results.csv]
2026-10-15 Resin print test plate: can a monolithic printed chip replace the milled one?
    One print job for the Formlabs Form Studio 1 in Alpha Clear (~15 mL), built
    by a parametric CadQuery script with inline dependencies, so
    `uv run gen_print_test_plate.py` regenerates everything with no setup.
    The case for printing is that a monolithic chip has the same material on
    floor, walls and ceiling, which removes the largest open unknown in the
    milled design: the PMMA-floor / 468MP-ceiling wetting mismatch that the 3D
    symmetry plane makes untestable in simulation. Printing raises four new
    questions instead; each coupon answers one.
    W channel width, 400-1200 um nominal square, open both ends, with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
2026-10-15 Size tubing and heads for the chip as drawn; shorten v2 chip runs
    The v2 drawing had 45 mm of on-chip oil path while the BOM tubing was
    sized for the simulation's 2 mm / 4 mm chip. Solving the shared-outlet
    network forward, the BOM tubing on that chip gave 35% of design oil flow
    and 12% of design water flow at the stated 10.0 / 5.0 cm heads.
    size_resistors.py now calibrates a lumped model of the simulated 2D
    network and matches the bench element by element, reading the chip
    coordinates from gen_guide_diagrams.py. The outlet is the one element
    that cannot match (4 mm of 2D slot = 1.7 mm of square duct), so its
    excess resistance is carried as an equal offset on both heads.
    Chip shortened to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
